OliWozniak/Projekt_EAP_OW/uMule_board/QR.png

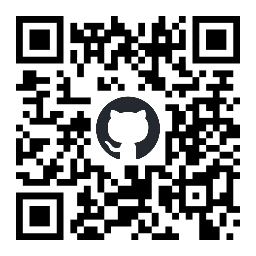
uMule_board/QR.png
