OliWozniak/Projekt_EAP_OW/(list of files, cad)

Other CAD files:
uMule_board/3d_models/uMule_board.step
