OliWozniak/Projekt_EAP_OW/uMule_board/pdf/pcb/uMule_board.pdf

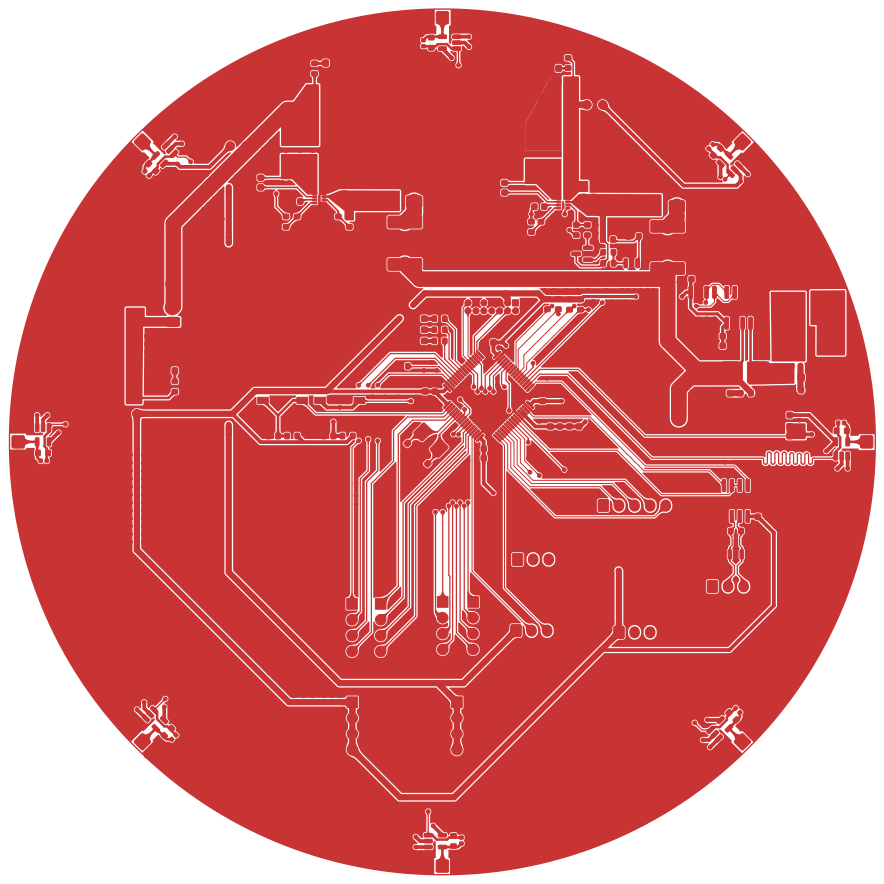
[picture p2: page 1]

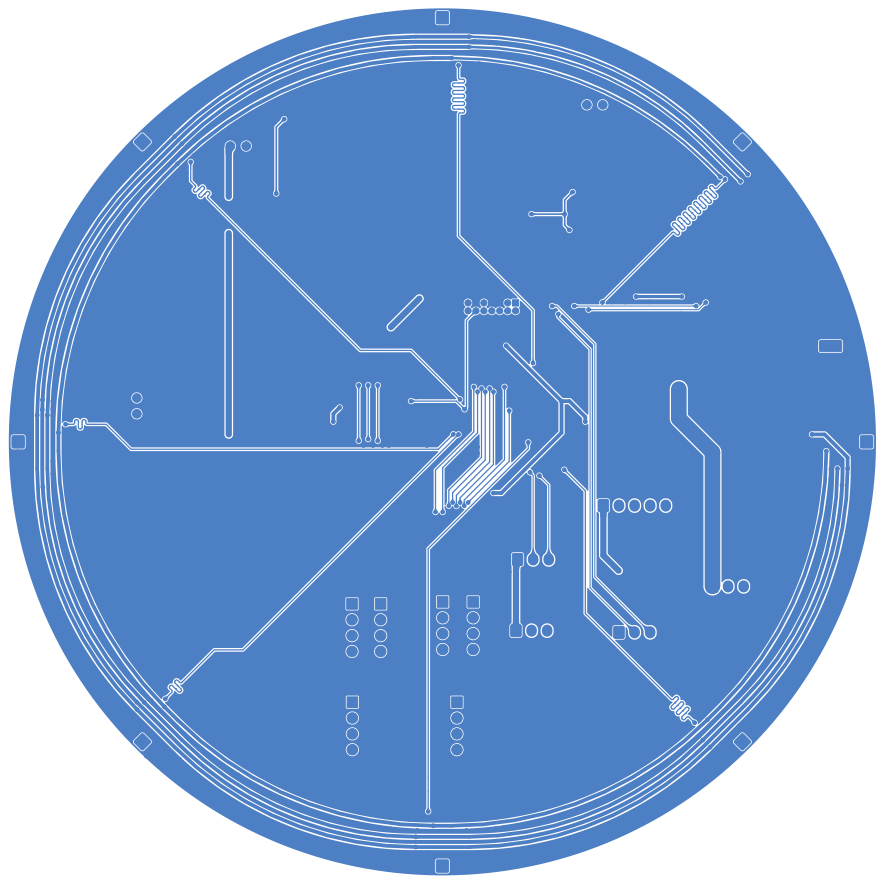
[picture p3: page 2]

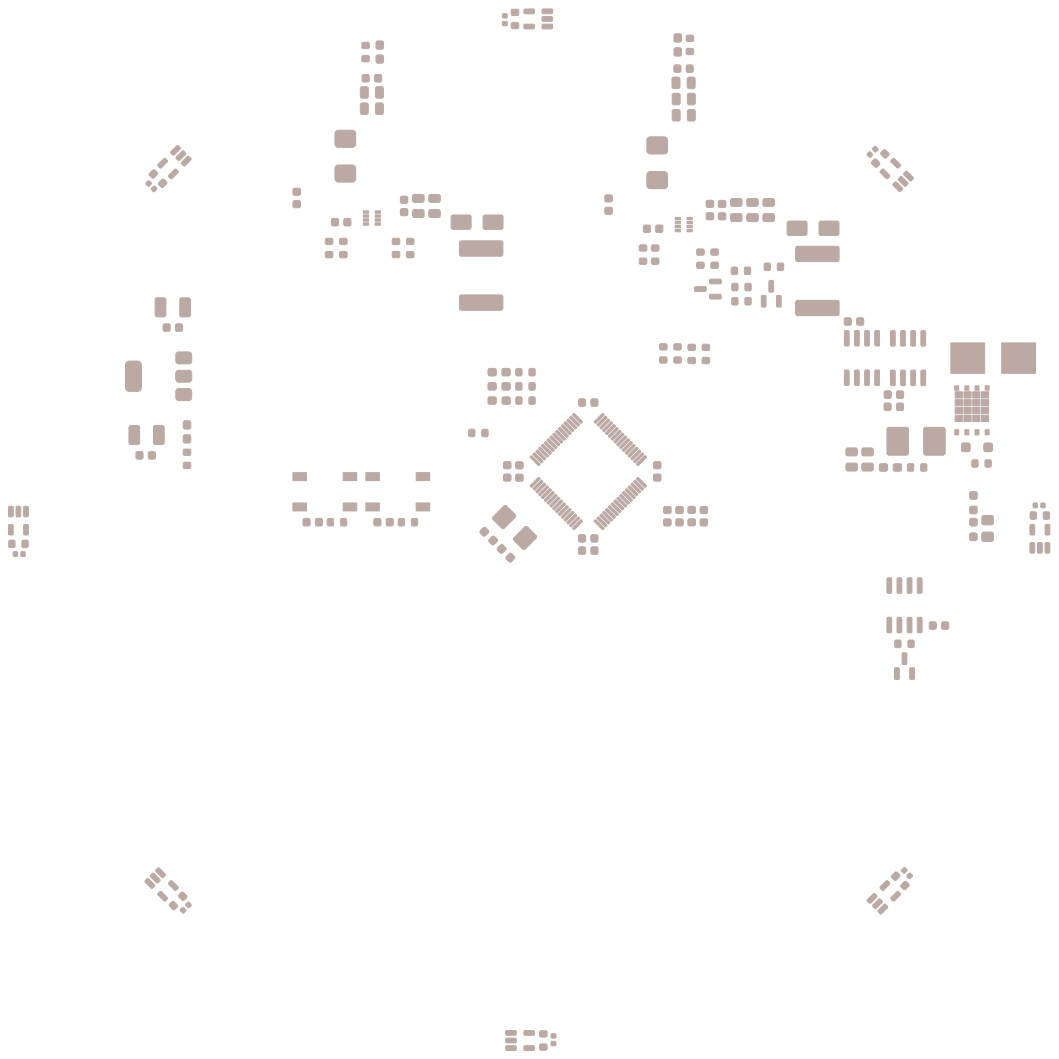
[picture p4: page 3]

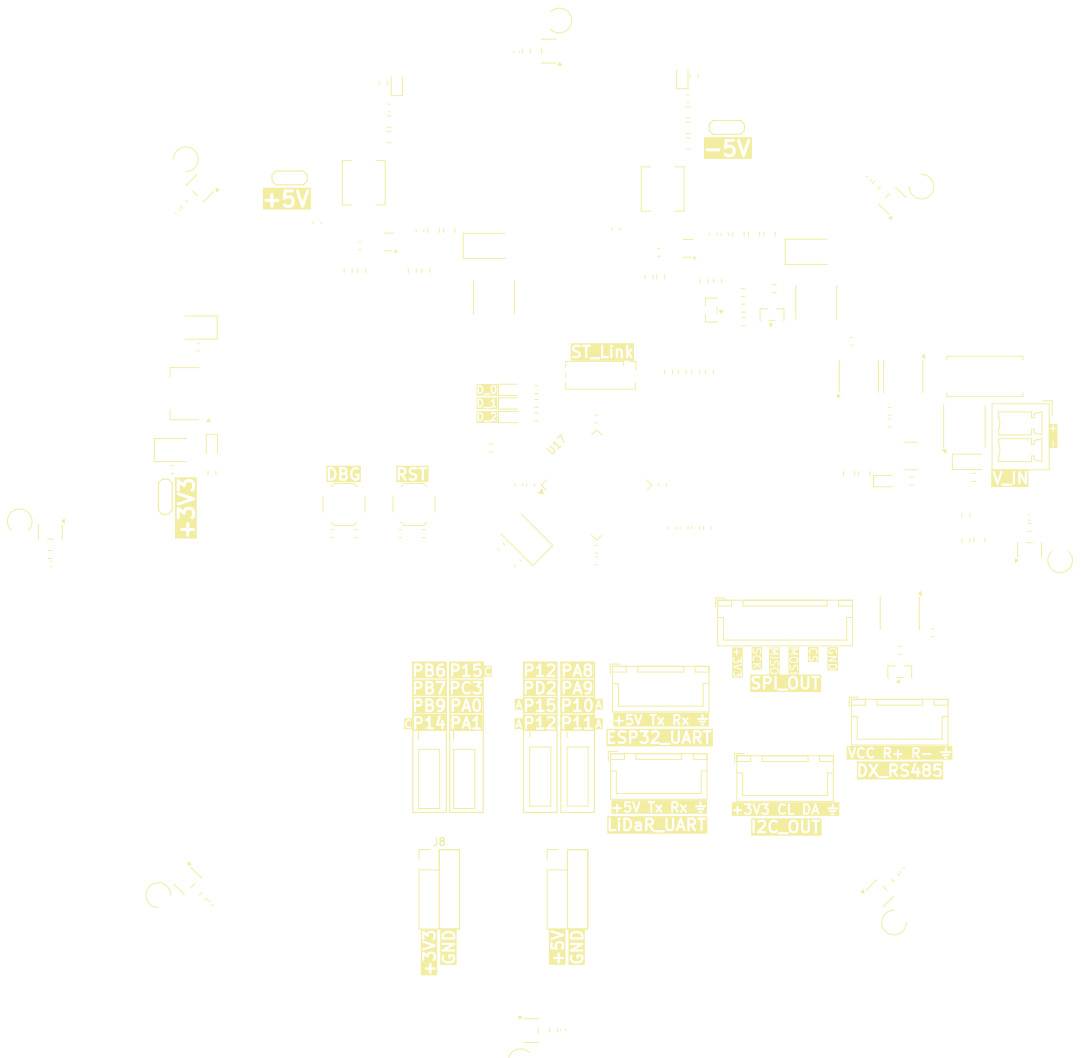
[picture p5: page 5]

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

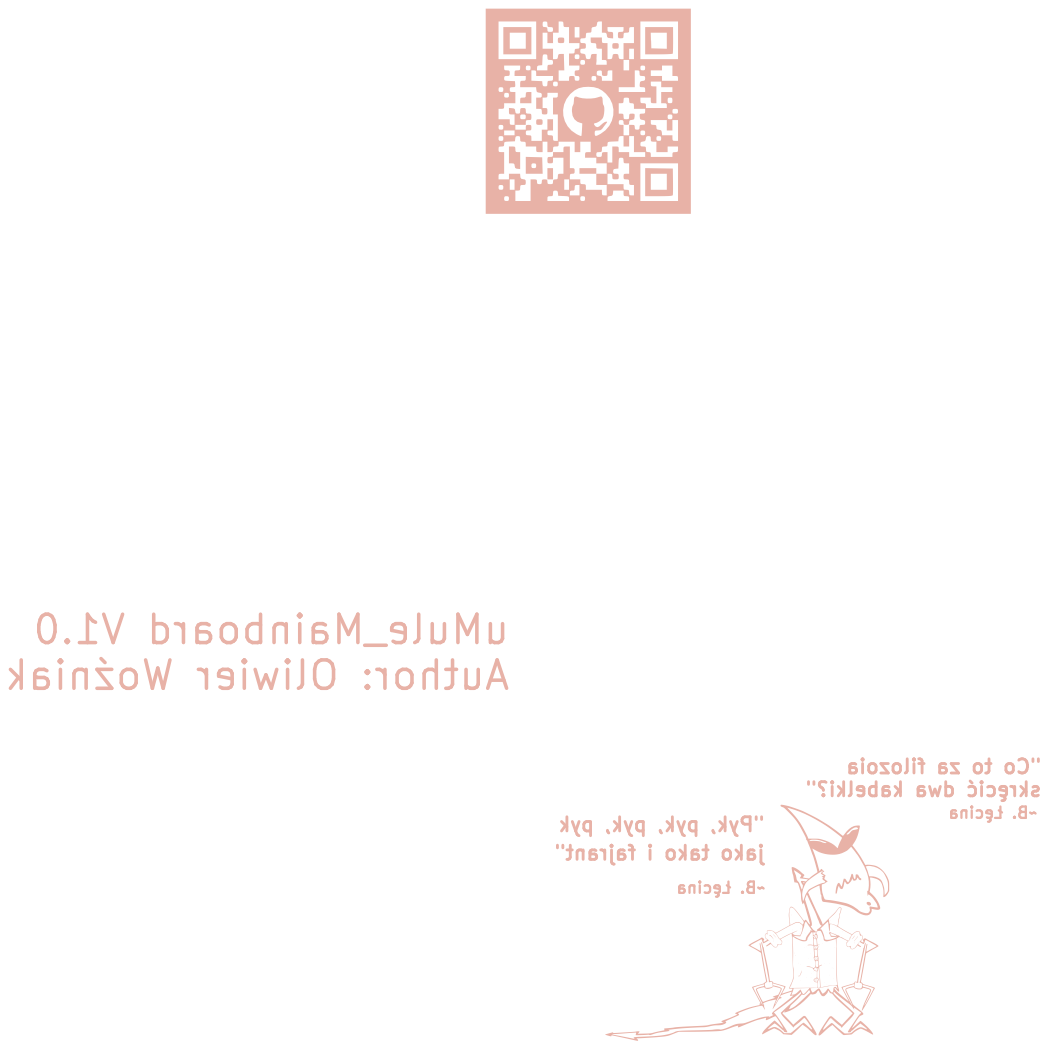
[picture p6: page 6]

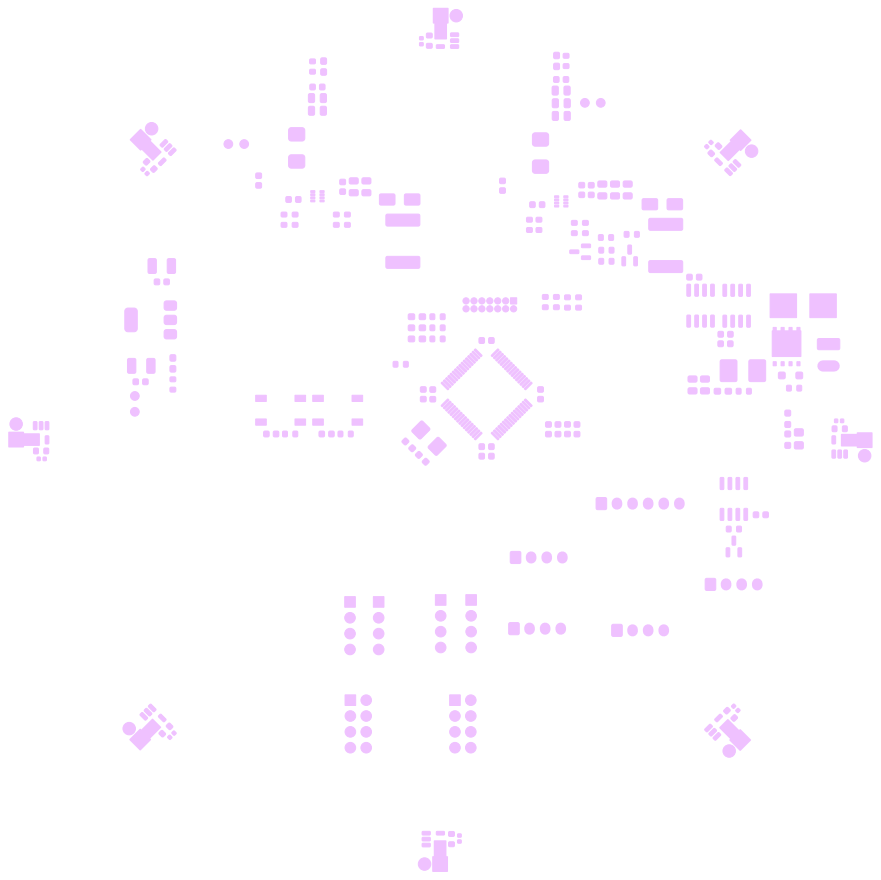
[picture p7: page 7]

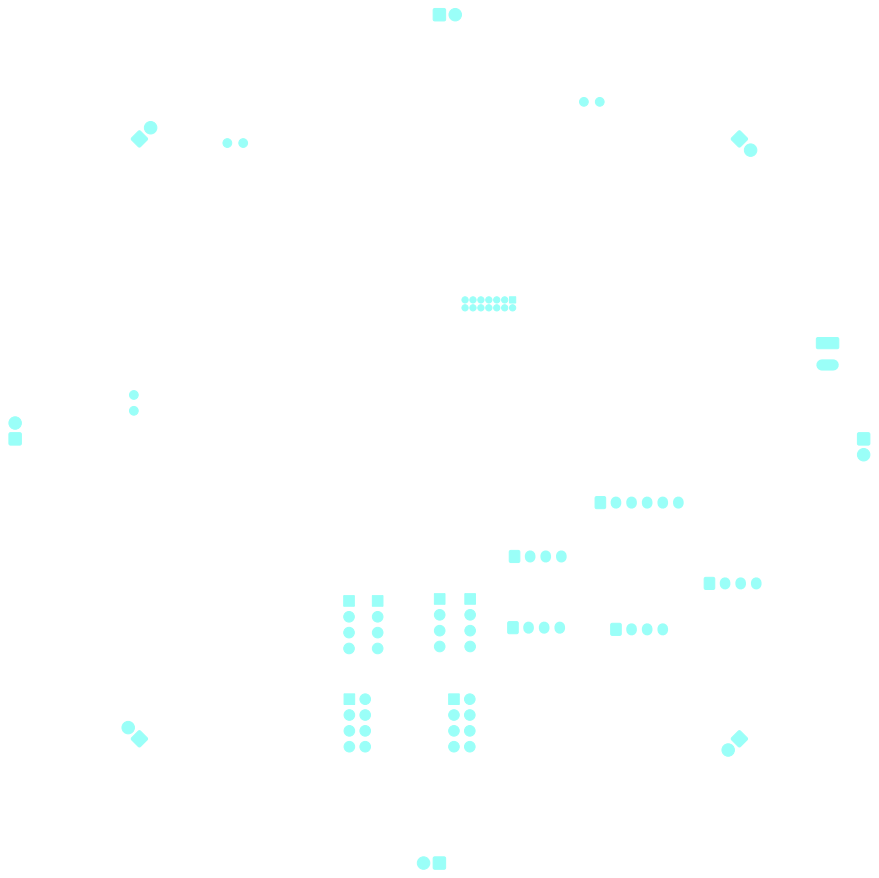
[picture p8: page 8]
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
