OliWozniak/Projekt_EAP_OW/uMule_transmiter/uMule_transmiter.kicad_pcb

## KiCad design uMule_transmiter/uMule_transmiter.kicad_pcb (2026-01-06)

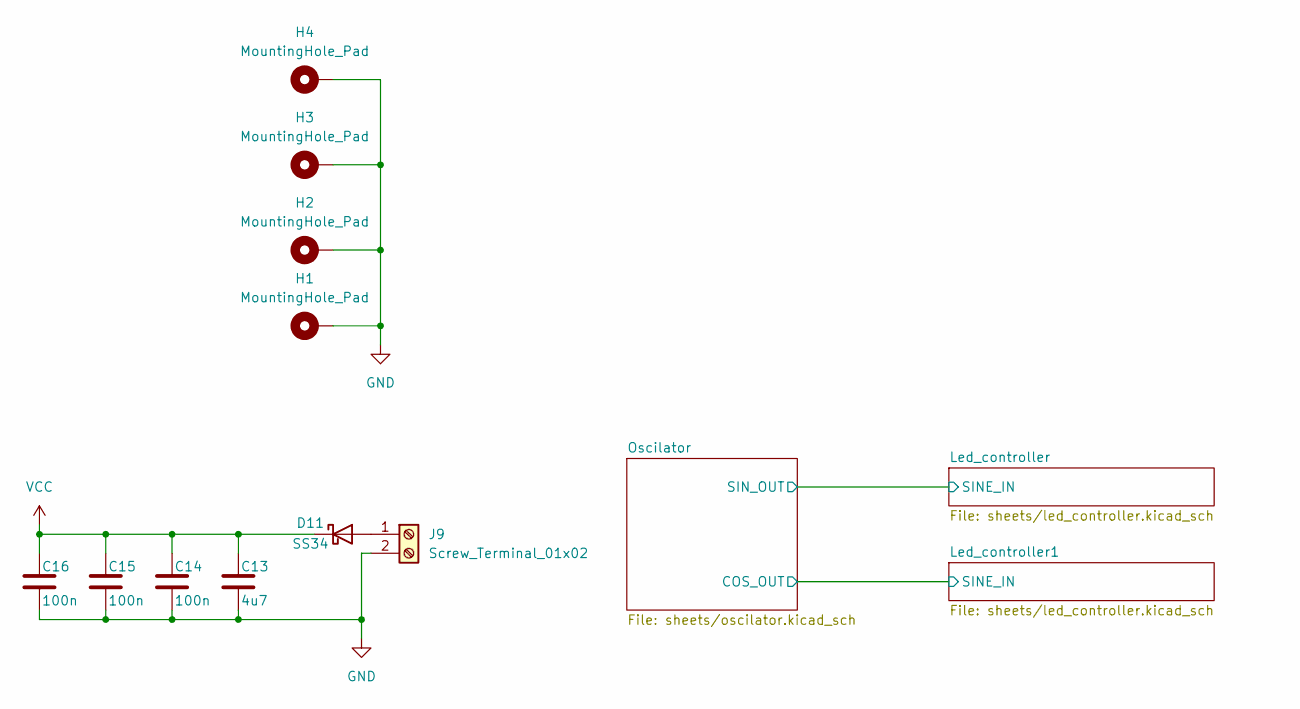
[picture p9: schematic uMule_transmiter.kicad_sch]

Parts:
C13: 4u7; C_0805_2012Metric
C14, C15, C16: 100n; C_0603_1608Metric_Pad1.08x0.95mm_HandSolder
D11: SS34; D_SMA
H1, H2, H3, H4: MountingHole_Pad; MountingHole_3.2mm_M3_Pad_Via
J9: Screw_Terminal_01x02; PhoenixContact_MCV_1,5_2-G-3.5_1x02_P3.50mm_Vertical

Connections:
GND: C13.2, C14.2, C15.2, C16.2, H1.1, H2.1, H3.1, H4.1, J9.2; also elsewhere on the board
unnamed: D11.2 (A), J9.1
VCC: C13.1, C14.1, C15.1, C16.1, D11.1 (K); also elsewhere on the board

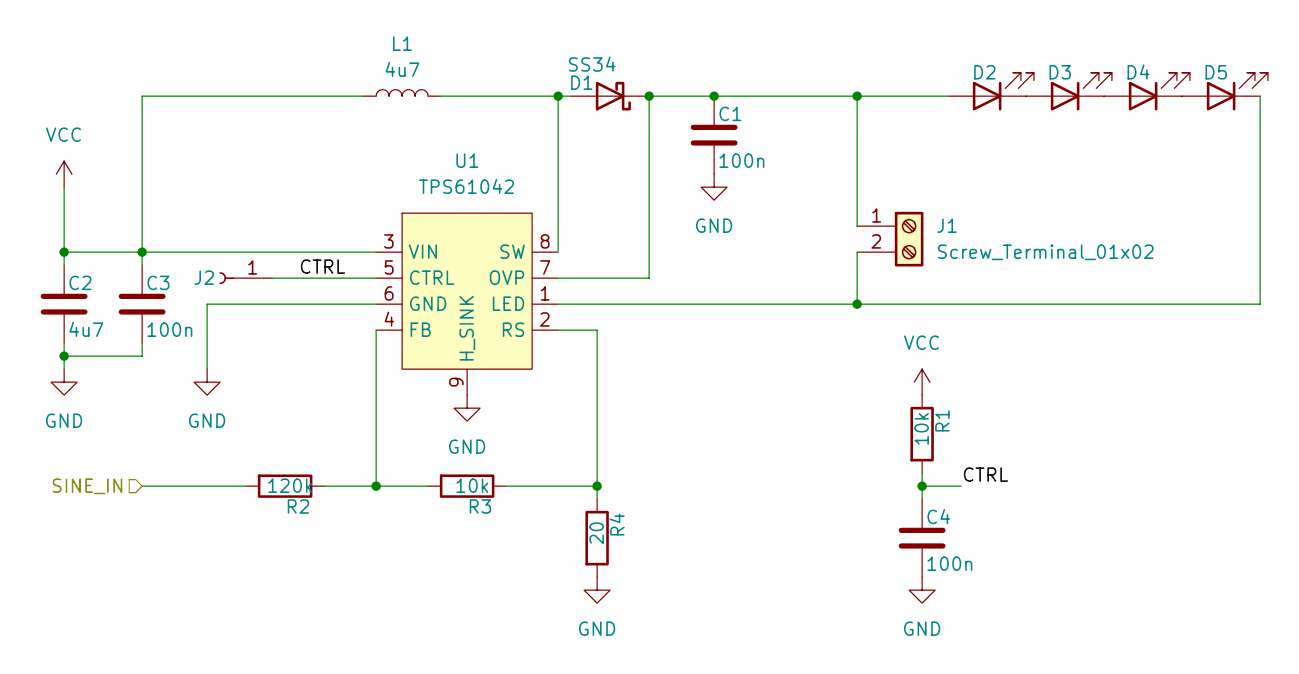
[picture p10: schematic led_controller.kicad_sch]

Parts:
C1, C3, C4: 100n; C_0603_1608Metric_Pad1.08x0.95mm_HandSolder
C2: 4u7; C_0805_2012Metric
D1: SS34; D_SMA
D2, D3, D4, D5: LED; LED_D5.0mm
J1: Screw_Terminal_01x02; PhoenixContact_MCV_1,5_2-G-3.5_1x02_P3.50mm_Vertical
J2: Conn_01x01_Socket; PinHeader_1x01_P2.54mm_Vertical
L1: 4u7; L_APV_ANR3015
R1, R3: 10k; R_0603_1608Metric_Pad0.98x0.95mm_HandSolder
R2: 120k; R_0603_1608Metric_Pad0.98x0.95mm_HandSolder
R4: 20; R_1206_3216Metric_Pad1.30x1.75mm_HandSolder
U1: TPS61042; Texas_S-PVSON-N8

Connections:
/Led_controller/CTRL: C4.1, J2.1, R1.2, U1.5 (CTRL)
/Led_controller/SINE_IN: R2.2; also elsewhere on the board
GND: C1.2, C2.2, C3.2, C4.2, R4.2, U1.6 (GND), U1.9 (H_SINK); also elsewhere on the board
unnamed: D1.2 (A), L1.2, U1.8 (SW)
unnamed: C1.1, D1.1 (K), D2.2 (A), J1.1, U1.7 (OVP)
unnamed: D2.1 (K), D3.2 (A)
unnamed: D3.1 (K), D4.2 (A)
unnamed: D4.1 (K), D5.2 (A)
unnamed: D5.1 (K), J1.2, U1.1 (LED)
unnamed: R2.1, R3.2, U1.4 (FB)
unnamed: R3.1, R4.1, U1.2 (RS)
VCC: C2.1, C3.1, L1.1, R1.1, U1.3 (VIN); also elsewhere on the board

Parts of its further copies:
C5, C7, C8: 100n; C_0603_1608Metric_Pad1.08x0.95mm_HandSolder
C6: 4u7; C_0805_2012Metric
D6: SS34; D_SMA
D7, D8, D9, D10: LED; LED_D5.0mm
J3: Screw_Terminal_01x02; PhoenixContact_MCV_1,5_2-G-3.5_1x02_P3.50mm_Vertical
J4: Conn_01x01_Socket; PinHeader_1x01_P2.54mm_Vertical
L2: 4u7; L_APV_ANR3015
R5, R7: 10k; R_0603_1608Metric_Pad0.98x0.95mm_HandSolder
R6: 120k; R_0603_1608Metric_Pad0.98x0.95mm_HandSolder
R8: 20; R_1206_3216Metric_Pad1.30x1.75mm_HandSolder
U2: TPS61042; Texas_S-PVSON-N8

Connections of its further copies:
/Led_controller1/CTRL: C8.1, J4.1, R5.2, U2.5 (CTRL)
/Led_controller1/SINE_IN: R6.2; also elsewhere on the board
GND: C5.2, C6.2, C7.2, C8.2, R8.2, U2.6 (GND), U2.9 (H_SINK); also elsewhere on the board
unnamed: D6.2 (A), L2.2, U2.8 (SW)
unnamed: C5.1, D6.1 (K), D7.2 (A), J3.1, U2.7 (OVP)
unnamed: D7.1 (K), D8.2 (A)
unnamed: D8.1 (K), D9.2 (A)
unnamed: D9.1 (K), D10.2 (A)
unnamed: D10.1 (K), J3.2, U2.1 (LED)
unnamed: R6.1, R7.2, U2.4 (FB)
unnamed: R7.1, R8.1, U2.2 (RS)
VCC: C6.1, C7.1, L2.1, R5.1, U2.3 (VIN); also elsewhere on the board

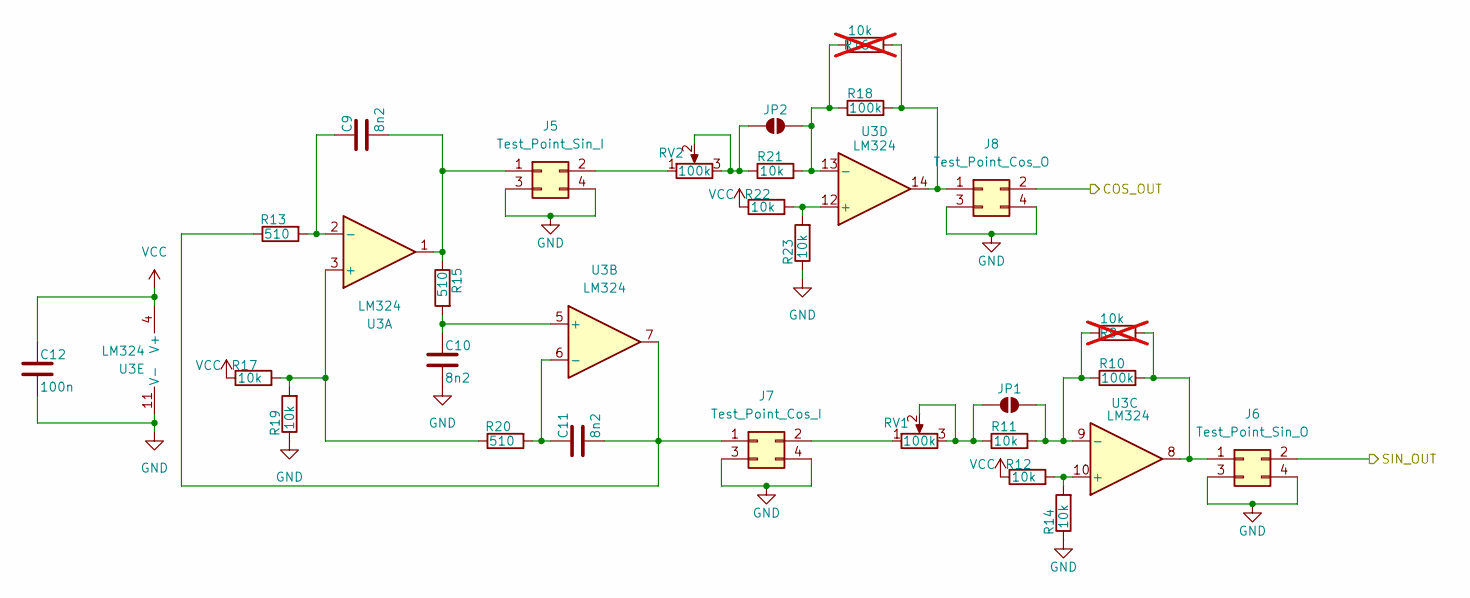
[picture p11: schematic oscilator.kicad_sch]

Parts:
C9, C10, C11: 8n2; C_0603_1608Metric_Pad1.08x0.95mm_HandSolder
C12: 100n; C_0603_1608Metric_Pad1.08x0.95mm_HandSolder
J5: Test_Point_Sin_I; PinHeader_2x02_P2.54mm_Vertical
J6: Test_Point_Sin_O; PinHeader_2x02_P2.54mm_Vertical
J7: Test_Point_Cos_I; PinHeader_2x02_P2.54mm_Vertical
J8: Test_Point_Cos_O; PinHeader_2x02_P2.54mm_Vertical
JP1, JP2: SolderJumper_2_Open; SolderJumper-2_P1.3mm_Open_RoundedPad1.0x1.5mm
R9, R16: 10k; R_Axial_DIN0207_L6.3mm_D2.5mm_P7.62mm_Horizontal; not fitted
R10, R18: 100k; R_0603_1608Metric_Pad0.98x0.95mm_HandSolder
R11, R12, R14, R17, R19, R21, R22, R23: 10k; R_0603_1608Metric_Pad0.98x0.95mm_HandSolder
R13, R15, R20: 510; R_0603_1608Metric_Pad0.98x0.95mm_HandSolder
RV1, RV2: 100k; Potentiometer_Bourns_3266Y_Vertical
U3: LM324; SOIC-14_3.9x8.7mm_P1.27mm

Connections:
/Led_controller1/SINE_IN: J8.2; also elsewhere on the board
/Led_controller/SINE_IN: J6.2; also elsewhere on the board
GND: C10.2, C12.2, J5.3, J5.4, J6.3, J6.4, J7.3, J7.4, J8.3, J8.4, R14.1, R19.1, R23.1, U3.11 (V-); also elsewhere on the board
unnamed: C9.2, J5.1, R15.1, U3.1
unnamed: J5.2, RV2.1
unnamed: J6.1, R9.2, R10.2, U3.8
unnamed: C11.2, J7.1, R13.1, U3.7
unnamed: J7.2, RV1.1
unnamed: J8.1, R16.2, R18.2, U3.14
unnamed: JP1.1 (A), R11.1, RV1.2, RV1.3
unnamed: JP1.2 (B), R9.1, R10.1, R11.2, U3.9 (-)
unnamed: JP2.1 (A), R21.1, RV2.2, RV2.3
unnamed: JP2.2 (B), R16.1, R18.1, R21.2, U3.13 (-)
unnamed: R17.2, R19.2, R20.1, U3.3 (+)
unnamed: C9.1, R13.2, U3.2 (-)
unnamed: C10.1, R15.2, U3.5 (+)
unnamed: C11.1, R20.2, U3.6 (-)
unnamed: R12.2, R14.2, U3.10 (+)
unnamed: R22.2, R23.2, U3.12 (+)
VCC: C12.1, R12.1, R17.1, R22.1, U3.4 (V+); also elsewhere on the board

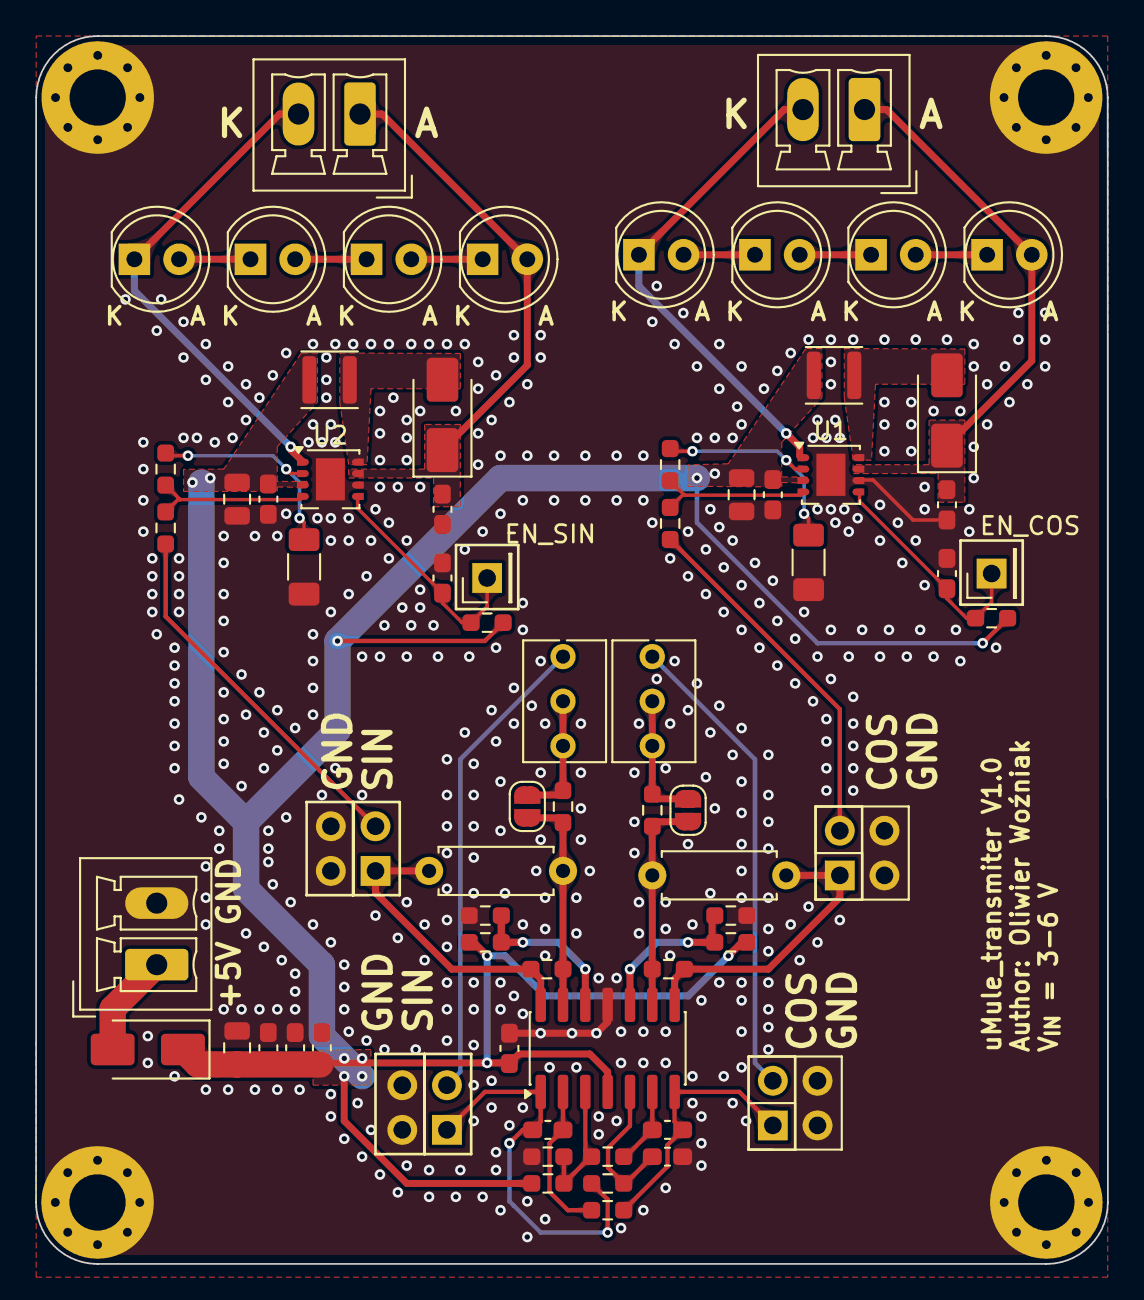
[picture p12: board uMule_transmiter.kicad_pcb from above]

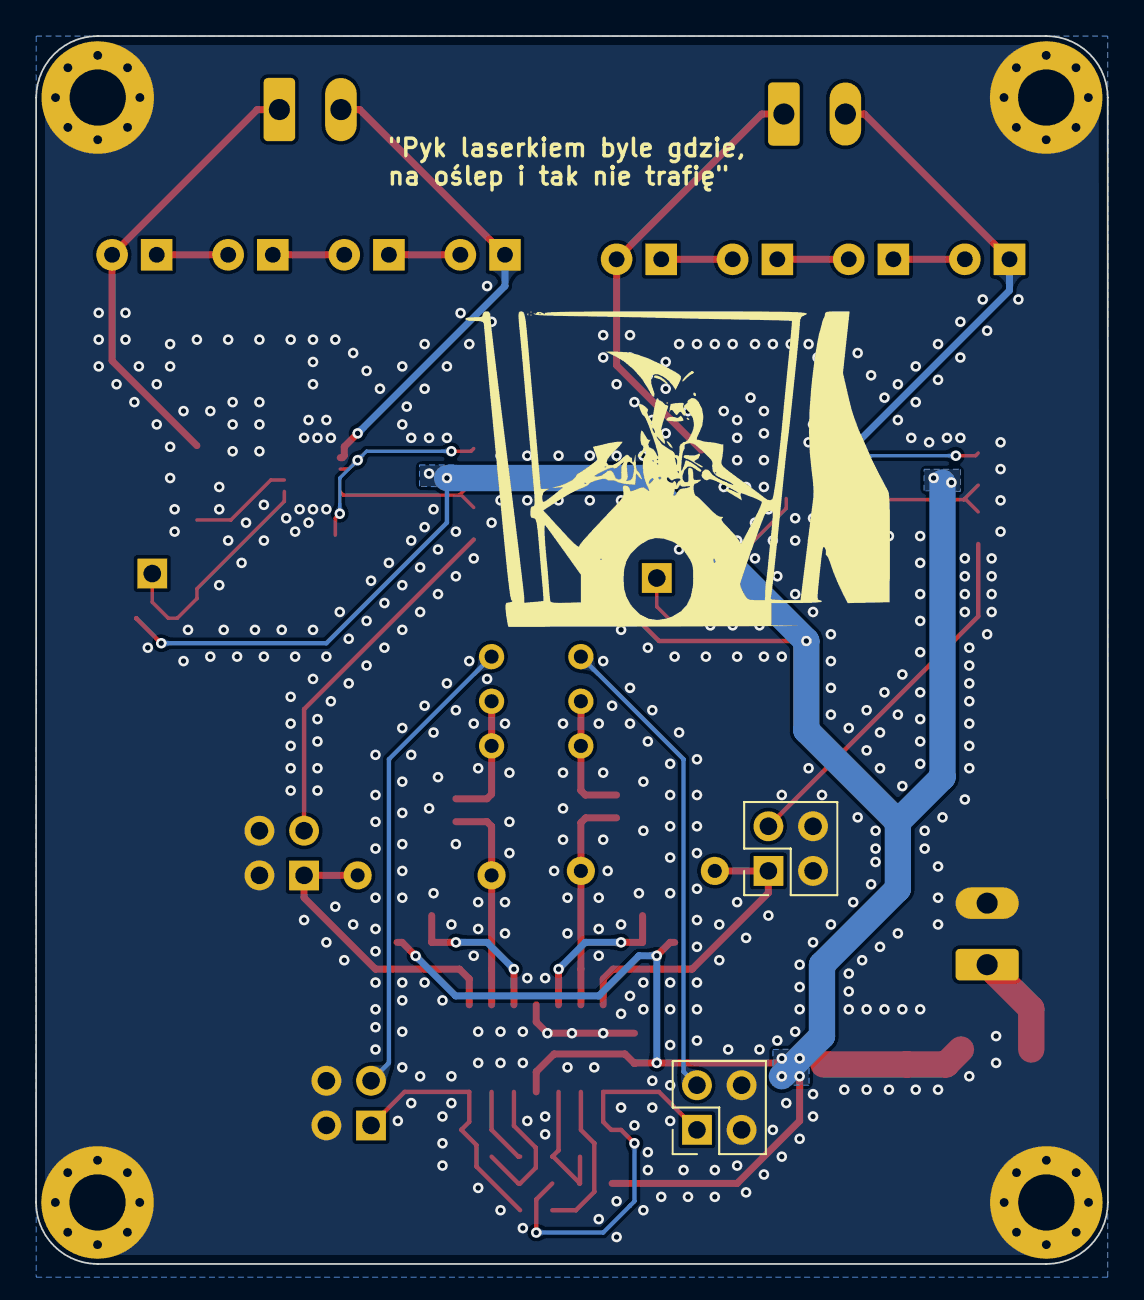
[picture p13: board uMule_transmiter.kicad_pcb from below]

Board: 2 copper layers, 61.0 x 69.9 mm, 72 parts (2 on the bottom side), 39 nets.
