OliWozniak/Projekt_EAP_OW/uMule_board/uMule_board.kicad_pcb

## KiCad design uMule_board/uMule_board.kicad_pcb (2026-01-04)

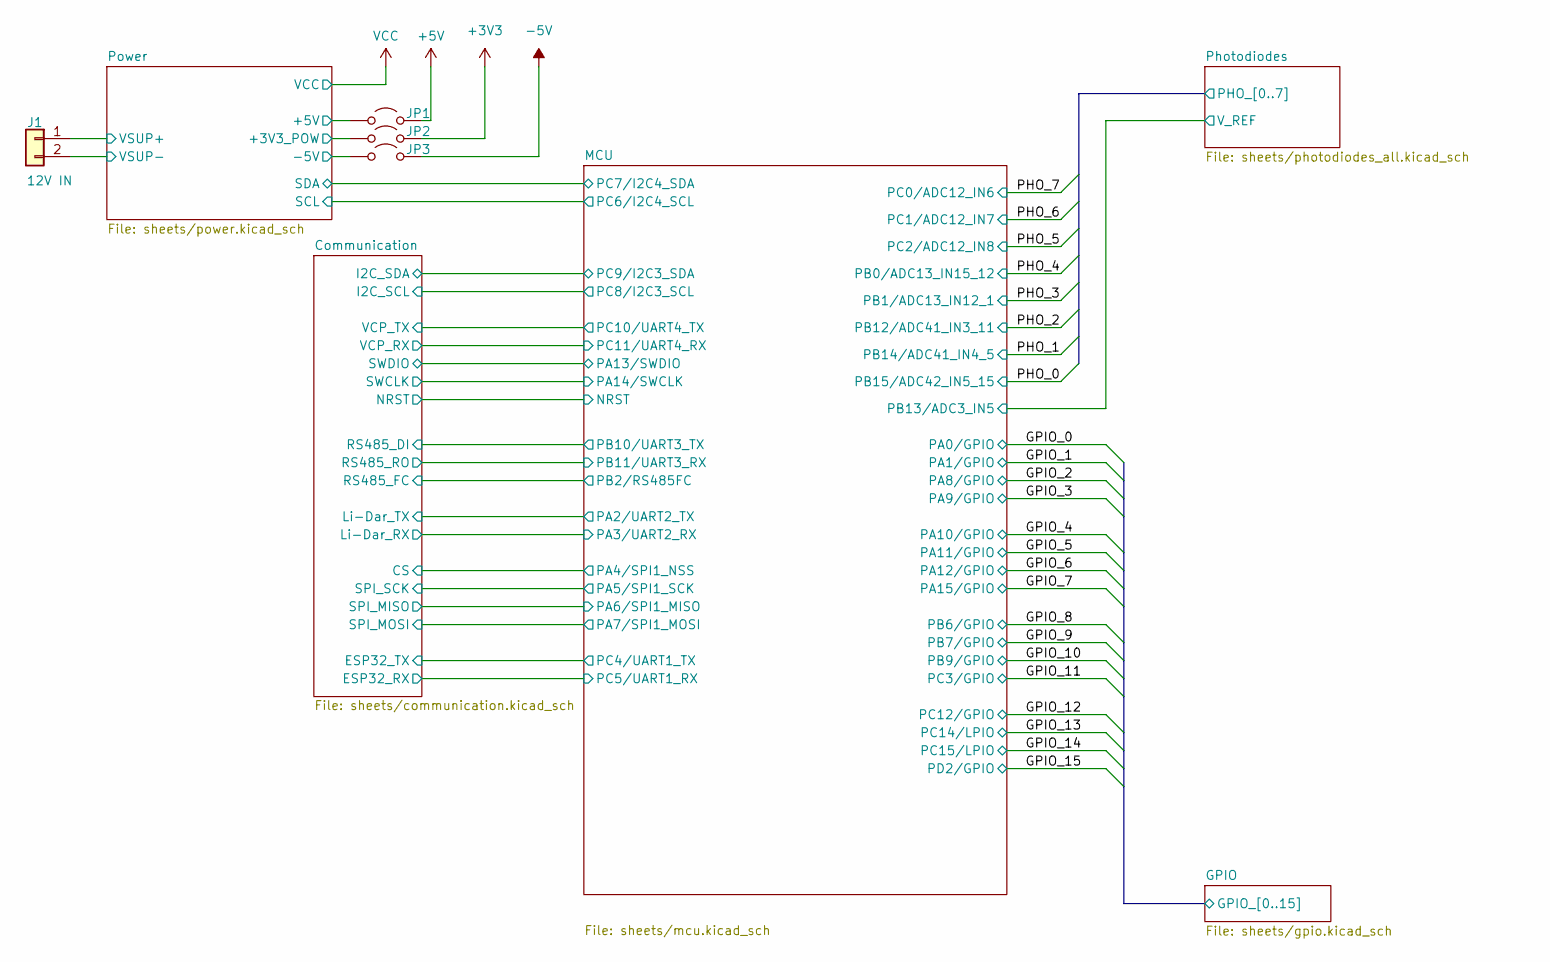
[picture p14: schematic uMule_board.kicad_sch]

Parts:
J1: 12V IN; PhoenixContact_MCV_1,5_2-G-3.5_1x02_P3.50mm_Vertical
JP1, JP2, JP3: Jumper_2_Open; TestPoint_2Pads_Pitch2.54mm_Drill0.8mm

Connections:
+3V3: JP2.2 (B); also elsewhere on the board
+5V: JP1.2 (B); also elsewhere on the board
-5V: JP3.2 (B); also elsewhere on the board
/Power/+3V3_POW: JP2.1 (A); also elsewhere on the board
/Power/+5V: JP1.1 (A); also elsewhere on the board
/Power/-5V: JP3.1 (A); also elsewhere on the board
/Power/VSUP+: J1.1; also elsewhere on the board
GND: J1.2; also elsewhere on the board

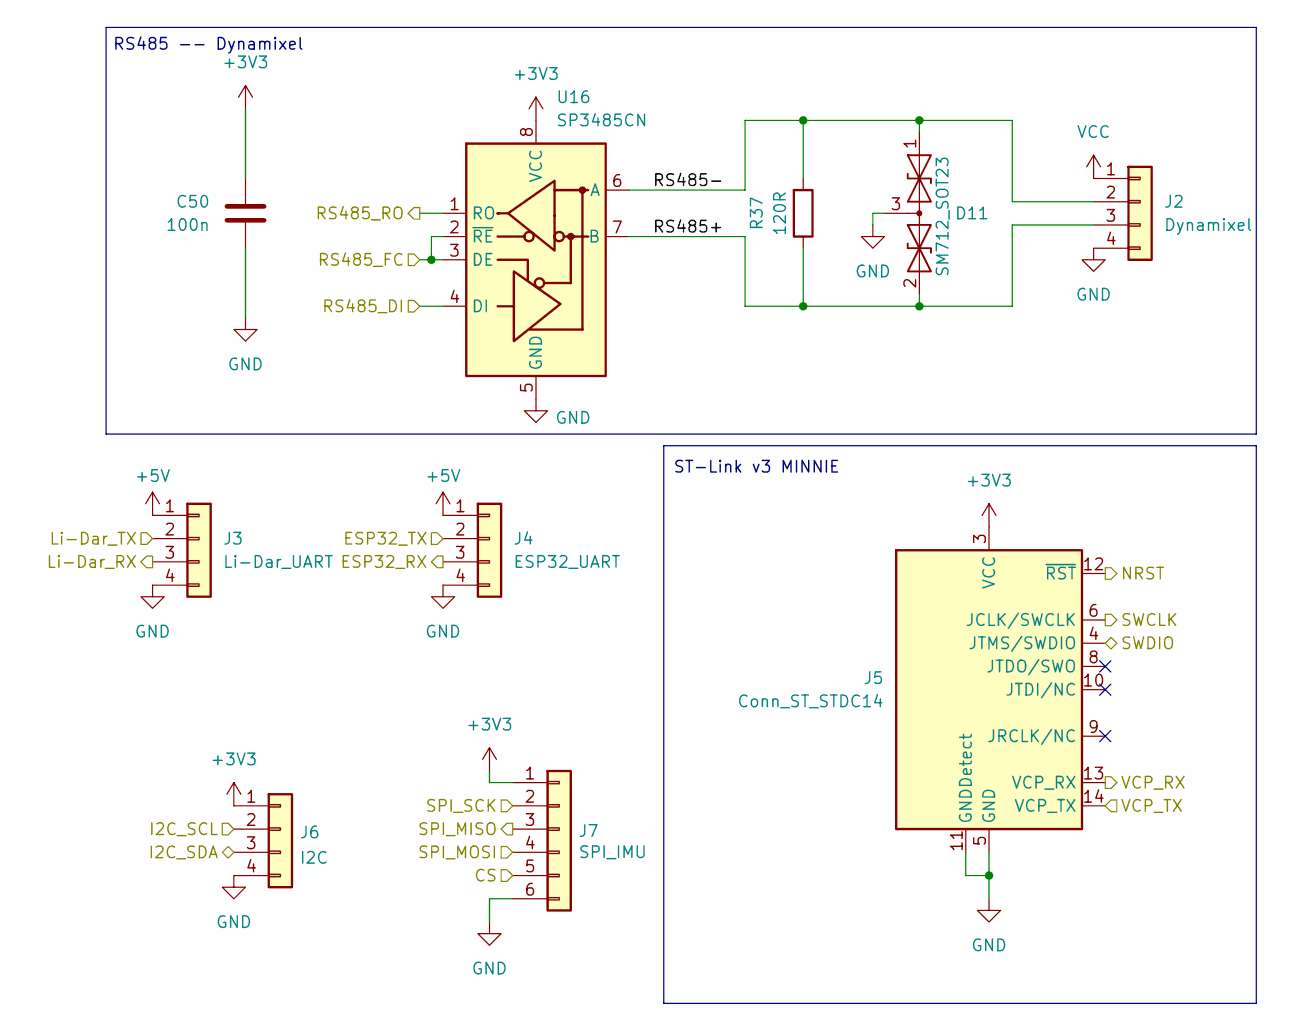
[picture p15: schematic communication.kicad_sch, uMule_board]

Parts:
C50: 100n; C_0603_1608Metric
D11: SM712_SOT23; SOT-23
J2: Dynamixel; JST_XH_B4B-XH-A_1x04_P2.50mm_Vertical
J3: Li-Dar_UART; JST_XH_B4B-XH-A_1x04_P2.50mm_Vertical
J4: ESP32_UART; JST_XH_B4B-XH-A_1x04_P2.50mm_Vertical
J5: Conn_ST_STDC14; PinHeader_2x07_P1.27mm_Vertical
J6: I2C; JST_XH_B4B-XH-A_1x04_P2.50mm_Vertical
J7: SPI_IMU; JST_XH_B6B-XH-A_1x06_P2.50mm_Vertical
R37: 120R; R_0603_1608Metric
U16: SP3485CN; SOIC-8_3.9x4.9mm_P1.27mm

Connections:
+3V3: C50.2, J5.3 (VCC), J6.1, J7.1, U16.8 (VCC); also elsewhere on the board
+5V: J3.1, J4.1; also elsewhere on the board
/Communication/CS: J7.5; also elsewhere on the board
/Communication/ESP32_RX: J4.3; also elsewhere on the board
/Communication/ESP32_TX: J4.2; also elsewhere on the board
/Communication/I2C_SCL: J6.2; also elsewhere on the board
/Communication/I2C_SDA: J6.3; also elsewhere on the board
/Communication/Li-Dar_RX: J3.3; also elsewhere on the board
/Communication/Li-Dar_TX: J3.2; also elsewhere on the board
/Communication/RS485+: D11.2 (A2), J2.3, R37.1, U16.7 (B)
/Communication/RS485-: D11.1 (A1), J2.2, R37.2, U16.6 (A)
/Communication/RS485_DI: U16.4 (DI); also elsewhere on the board
/Communication/RS485_FC: U16.2 (~RE), U16.3 (DE); also elsewhere on the board
/Communication/RS485_RO: U16.1 (RO); also elsewhere on the board
/Communication/SPI_MISO: J7.3; also elsewhere on the board
/Communication/SPI_MOSI: J7.4; also elsewhere on the board
/Communication/SPI_SCK: J7.2; also elsewhere on the board
/Communication/SWCLK: J5.6 (JCLK/SWCLK); also elsewhere on the board
/Communication/SWDIO: J5.4 (JTMS/SWDIO); also elsewhere on the board
/Communication/VCP_RX: J5.13 (VCP_RX); also elsewhere on the board
/Communication/VCP_TX: J5.14 (VCP_TX); also elsewhere on the board
/MCU/NRST: J5.12 (~RST); also elsewhere on the board
GND: C50.1, D11.3 (common), J2.4, J3.4, J4.4, J5.5 (GND), J5.7 (GND), J5.11 (GNDDetect), J6.4, J7.6, U16.5 (GND); also elsewhere on the board
VCC: J2.1; also elsewhere on the board

Notes on the sheet:
RS485 -- Dynamixel
ST-Link v3 MINNIE

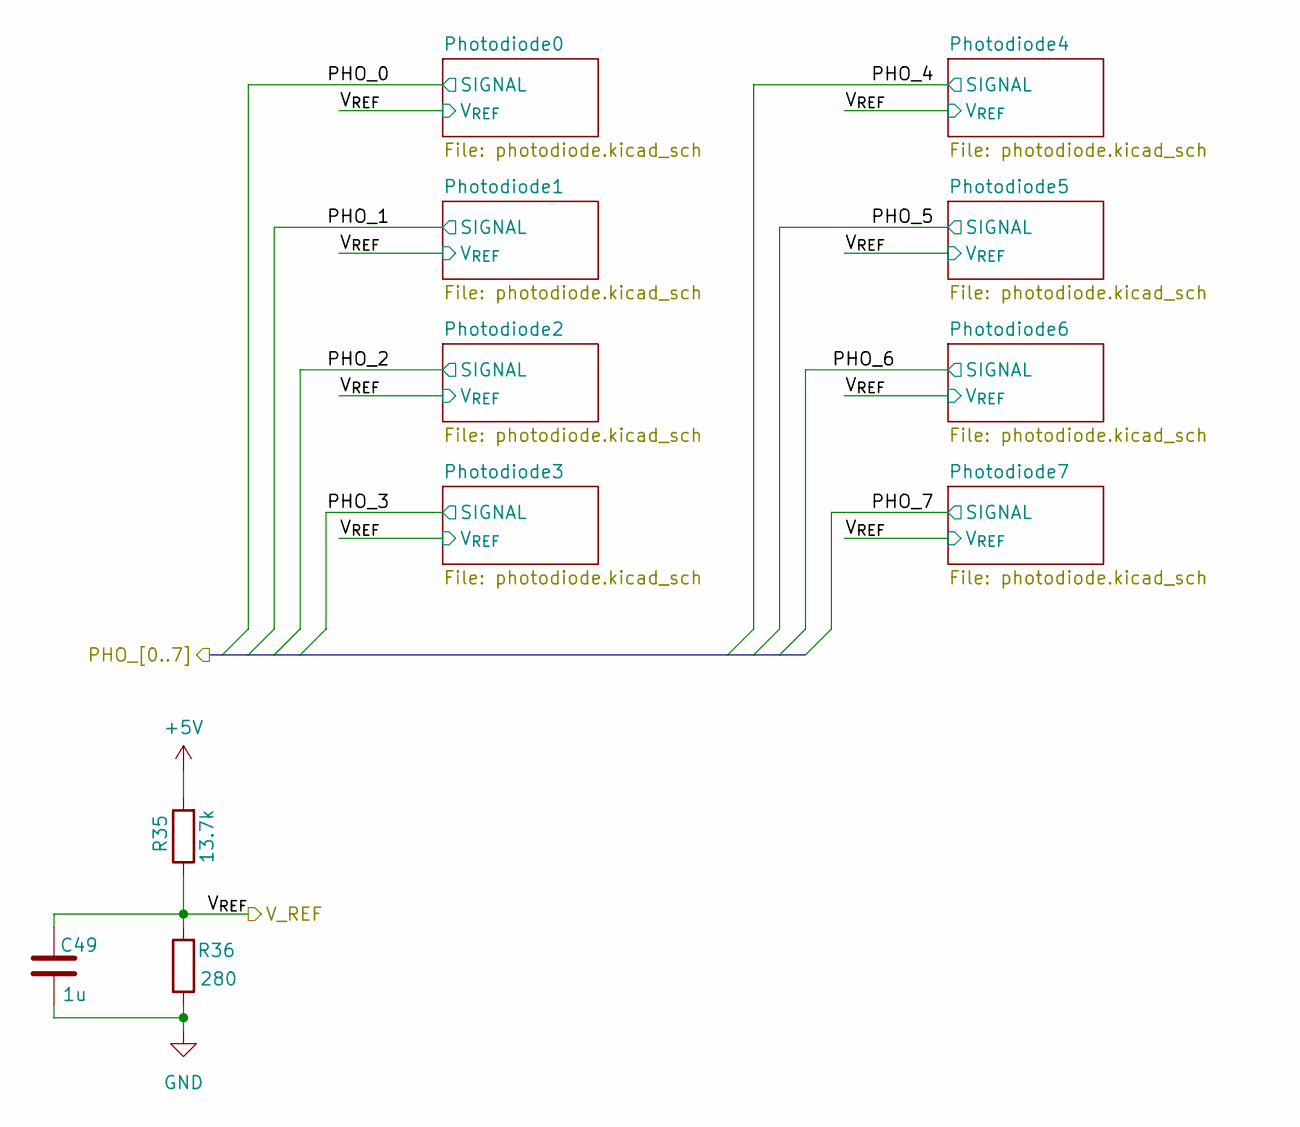
[picture p16: schematic photodiodes_all.kicad_sch, uMule_board]

Parts:
C49: 1u; C_0805_2012Metric_Pad1.18x1.45mm_HandSolder
R35: 13.7k; R_0603_1608Metric_Pad0.98x0.95mm_HandSolder
R36: 280; R_0603_1608Metric_Pad0.98x0.95mm_HandSolder

Connections:
+5V: R35.2; also elsewhere on the board
/Photodiodes/V_{REF}: C49.1, R35.1, R36.2; also elsewhere on the board
GND: C49.2, R36.1; also elsewhere on the board

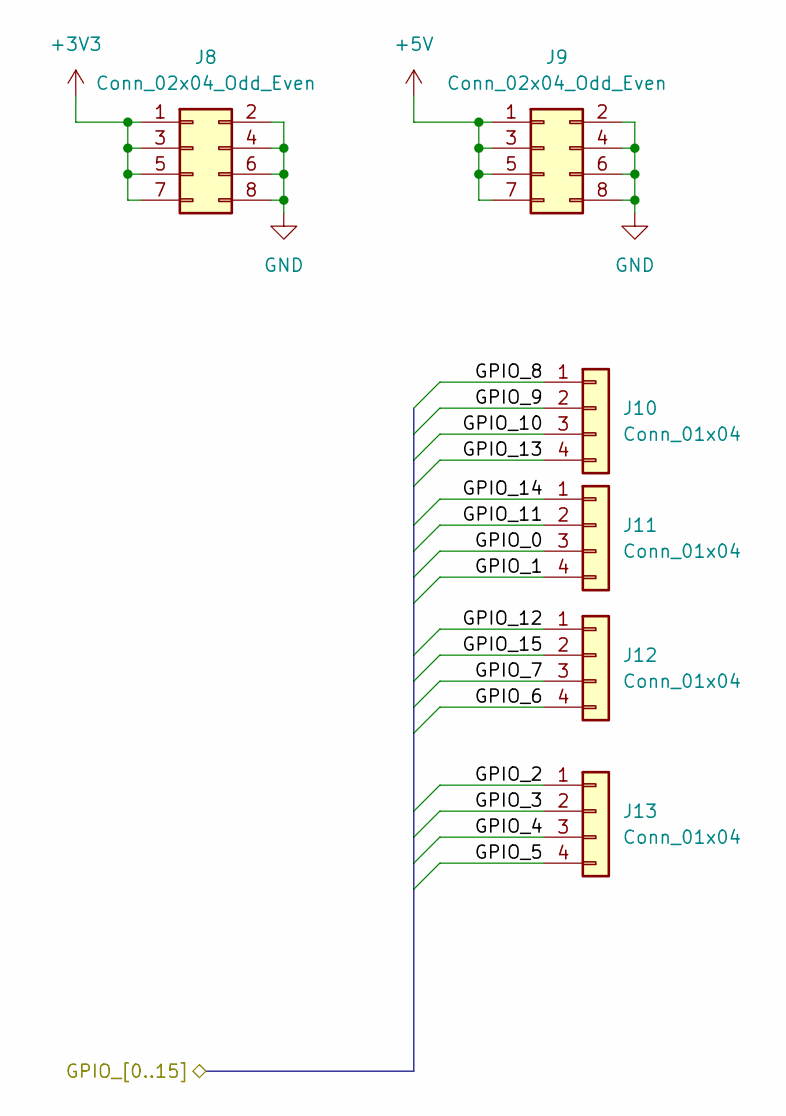
[picture p17: schematic gpio.kicad_sch, uMule_board]

Parts:
J8, J9: Conn_02x04_Odd_Even; PinHeader_2x04_P2.54mm_Vertical
J10, J11, J12, J13: Conn_01x04; PinHeader_1x04_P2.54mm_Vertical

Connections:
+3V3: J8.1, J8.3, J8.5, J8.7; also elsewhere on the board
+5V: J9.1, J9.3, J9.5, J9.7; also elsewhere on the board
/GPIO/GPIO_0: J11.3; also elsewhere on the board
/GPIO/GPIO_1: J11.4; also elsewhere on the board
/GPIO/GPIO_2: J13.1; also elsewhere on the board
/GPIO/GPIO_3: J13.2; also elsewhere on the board
/GPIO/GPIO_4: J13.3; also elsewhere on the board
/GPIO/GPIO_5: J13.4; also elsewhere on the board
/GPIO/GPIO_6: J12.4; also elsewhere on the board
/GPIO/GPIO_7: J12.3; also elsewhere on the board
/GPIO/GPIO_8: J10.1; also elsewhere on the board
/GPIO/GPIO_9: J10.2; also elsewhere on the board
/GPIO/GPIO_10: J10.3; also elsewhere on the board
/GPIO/GPIO_11: J11.2; also elsewhere on the board
/GPIO/GPIO_12: J12.1; also elsewhere on the board
/GPIO/GPIO_13: J10.4; also elsewhere on the board
/GPIO/GPIO_14: J11.1; also elsewhere on the board
/GPIO/GPIO_15: J12.2; also elsewhere on the board
GND: J8.2, J8.4, J8.6, J8.8, J9.2, J9.4, J9.6, J9.8; also elsewhere on the board

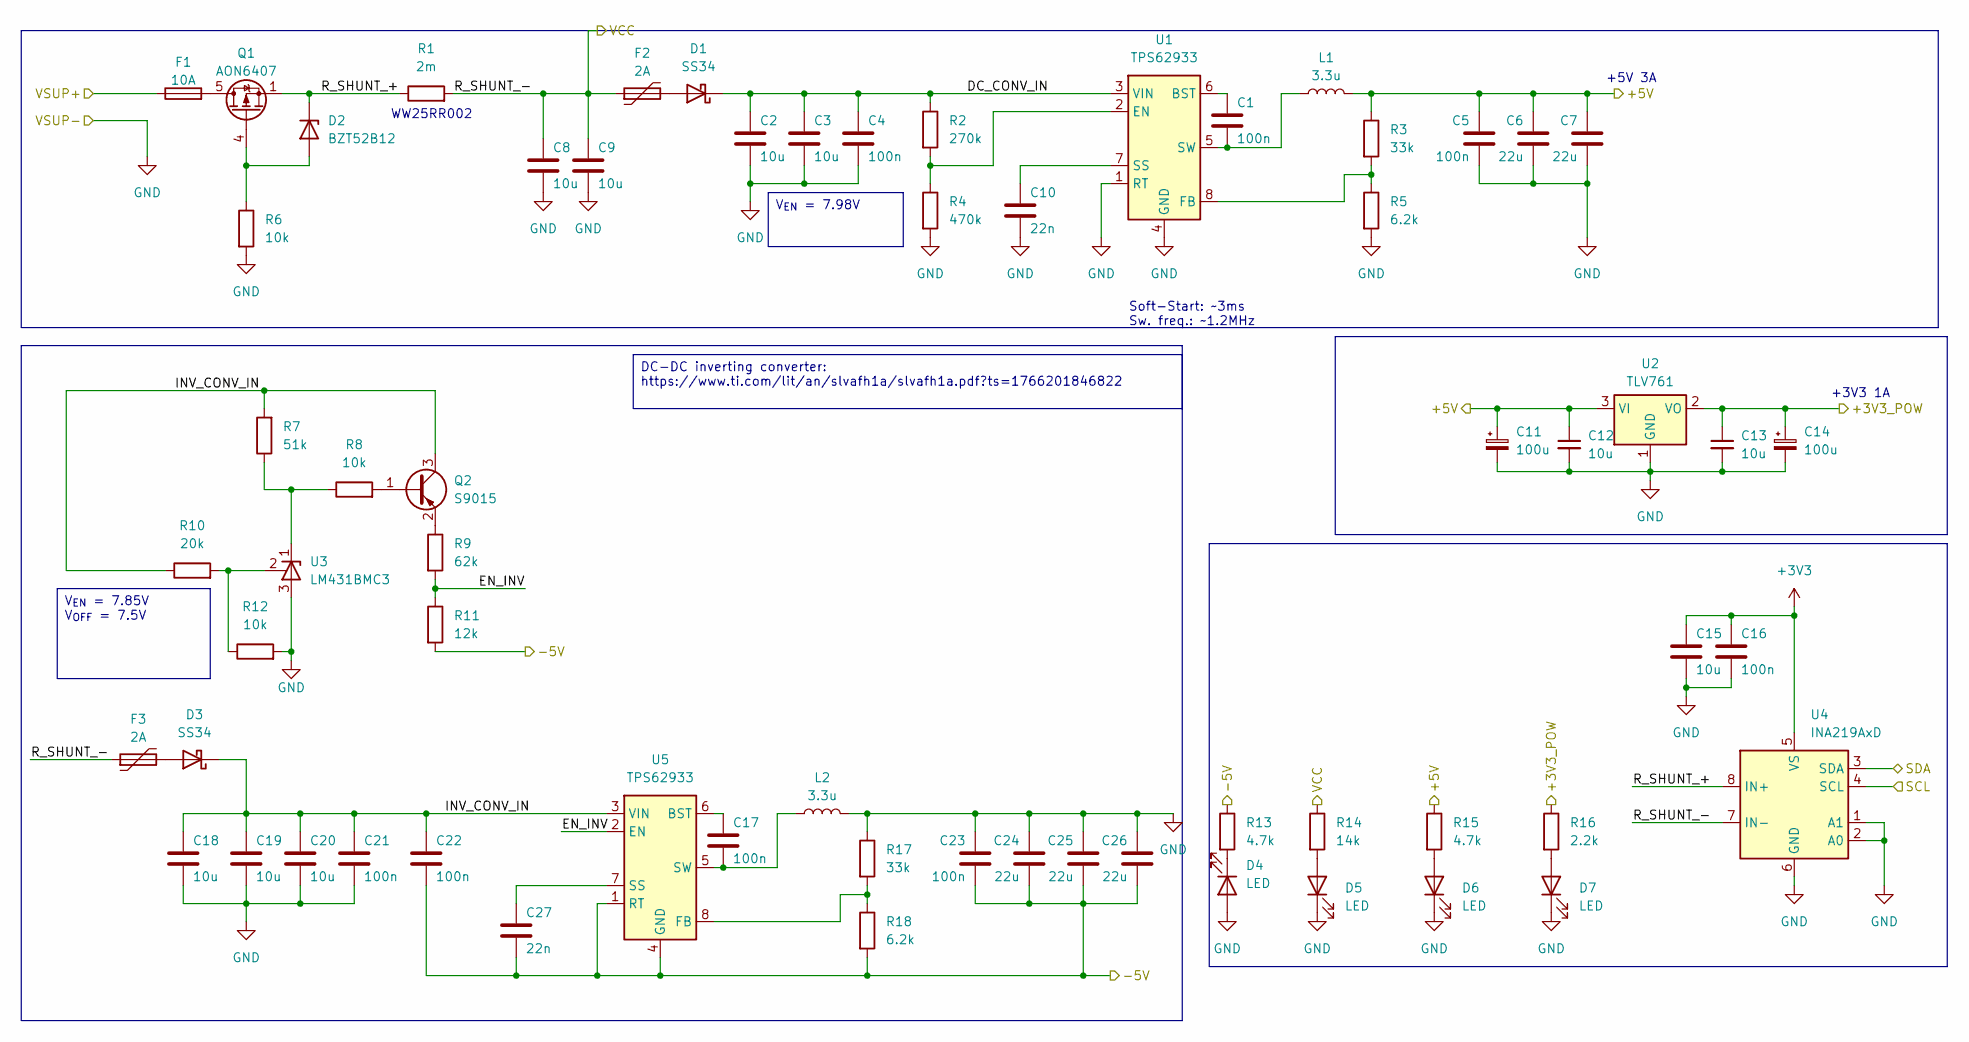
[picture p18: schematic power.kicad_sch, uMule_board]

Parts:
C1, C4, C5, C16, C17, C21, C22, C23: 100n; C_0603_1608Metric
C2, C3, C8, C9, C18, C19, C20: 10u; C_0805_2012Metric
C6, C7, C24, C25, C26: 22u; C_0805_2012Metric
C10, C27: 22n; C_0603_1608Metric
C11, C14: 100u; CP_EIA-3528-21_Kemet-B
C12, C13, C15: 10u; C_0603_1608Metric
D1, D3: SS34; D_SMA
D2: BZT52B12; D_SOD-123F
D4, D5, D6, D7: LED; LED_0603_1608Metric_Pad1.05x0.95mm_HandSolder
F1: 10A; Fuseholder_Littelfuse_Nano2_154x
F2, F3: 2A; Fuse_2920_7451Metric
L1, L2: 3.3u; Inductor_TKD_SPM5030VT; jlc C1512760
Q1: AON6407; AO_DFN-8-1EP_5.55x5.2mm_P1.27mm_EP4.12x4.6mm
Q2: S9015; SOT-23
R1: 2m; R_Shunt_2512
R2: 270k; R_0603_1608Metric
R3, R17: 33k; R_0603_1608Metric
R4: 470k; R_0603_1608Metric
R5, R18: 6.2k; R_0603_1608Metric
R6, R8, R12: 10k; R_0603_1608Metric
R7: 51k; R_0603_1608Metric
R9: 62k; R_0603_1608Metric
R10: 20k; R_0603_1608Metric
R11: 12k; R_0603_1608Metric
R13, R15: 4.7k; R_0603_1608Metric
R14: 14k; R_0603_1608Metric
R16: 2.2k; R_0603_1608Metric
U1, U5: TPS62933; SOT-583-8
U2: TLV761; SOT-223-3_TabPin2
U3: LM431BMC3; SOT-23
U4: INA219AxD; SOIC-8_3.9x4.9mm_P1.27mm

Connections:
+3V3: C15.1, C16.1, U4.5 (VS); also elsewhere on the board
/MCU/PC6/I2C4_SCL: U4.4 (SCL); also elsewhere on the board
/MCU/PC7/I2C4_SDA: U4.3 (SDA); also elsewhere on the board
/Power/+3V3_POW: C13.1, C14.1, R16.1, U2.2 (VO); also elsewhere on the board
/Power/+5V: C5.1, C6.1, C7.1, C11.1, C12.1, L1.2, R3.1, R15.1, U2.3 (VI); also elsewhere on the board
/Power/-5V: C22.2, C23.2, C24.2, C25.2, C26.2, C27.2, R11.2, R13.1, R18.2, U5.1 (RT), U5.4 (GND); also elsewhere on the board
/Power/DC_CONV_IN: C2.1, C3.1, C4.1, D1.1 (K), R2.1, U1.3 (VIN)
/Power/EN_INV: R9.2, R11.1, U5.2 (EN)
/Power/INV_CONV_IN: C18.1, C19.1, C20.1, C21.1, C22.1, D3.1 (K), Q2.3 (C), R7.2, R10.1, U5.3 (VIN)
/Power/R_SHUNT_+: D2.1 (K), Q1.1 (S), Q1.2 (S), Q1.3 (S), R1.1, U4.8 (IN+)
/Power/VSUP+: F1.1; also elsewhere on the board
GND: C2.2, C3.2, C4.2, C5.2, C6.2, C7.2, C8.2, C9.2, C10.2, C11.2, C12.2, C13.2, C14.2, C15.2, C16.2, C18.2, C19.2, C20.2, C21.2, C23.1, C24.1, C25.1, C26.1, D4.2 (A), D5.1 (K), D6.1 (K), D7.1 (K), L2.2, R4.2, R5.2, R6.2, R12.2, R17.1, U1.1 (RT), U1.4 (GND), U2.1 (GND), U3.3 (A), U4.1 (A1), U4.2 (A0), U4.6 (GND); also elsewhere on the board
unnamed: D1.2 (A), F2.2
unnamed: D2.2 (A), Q1.4 (G), R6.1
unnamed: D3.2 (A), F3.2
unnamed: D4.1 (K), R13.2
unnamed: D5.2 (A), R14.2
unnamed: D6.2 (A), R15.2
unnamed: D7.2 (A), R16.2
unnamed: F1.2, Q1.5 (D)
unnamed: Q2.1 (B), R8.2
unnamed: Q2.2 (E), R9.1
unnamed: C1.1, U1.6 (BST)
unnamed: R2.2, R4.1, U1.2 (EN)
unnamed: R3.2, R5.1, U1.8 (FB)
unnamed: C10.1, U1.7 (SS)
unnamed: C1.2, L1.1, U1.5 (SW)
unnamed: R7.1, R8.1, U3.1 (K)
unnamed: R10.2, R12.1, U3.2 (REF)
unnamed: C17.1, U5.6 (BST)
unnamed: R17.2, R18.1, U5.8 (FB)
unnamed: C27.1, U5.7 (SS)
unnamed: C17.2, L2.1, U5.5 (SW)
VCC: C8.1, C9.1, F2.1, F3.1, R1.2, R14.1, U4.7 (IN-); also elsewhere on the board

Notes on the sheet:
+3V3 1A
+5V 3A
Soft-Start: ~3ms Sw. freq.: ~1.2MHz
WW25RR002
V_{EN} = 7.85V V_{OFF} = 7.5V
V_{EN} = 7.98V
DC-DC inverting converter: https://www.ti.com/lit/an/slvafh1a/slvafh1a.pdf?ts=1766201846822
