OliWozniak/Projekt_EAP_OW/uMule_board/uMule_board.kicad_pcb

## KiCad design uMule_board/uMule_board.kicad_pcb (continued)

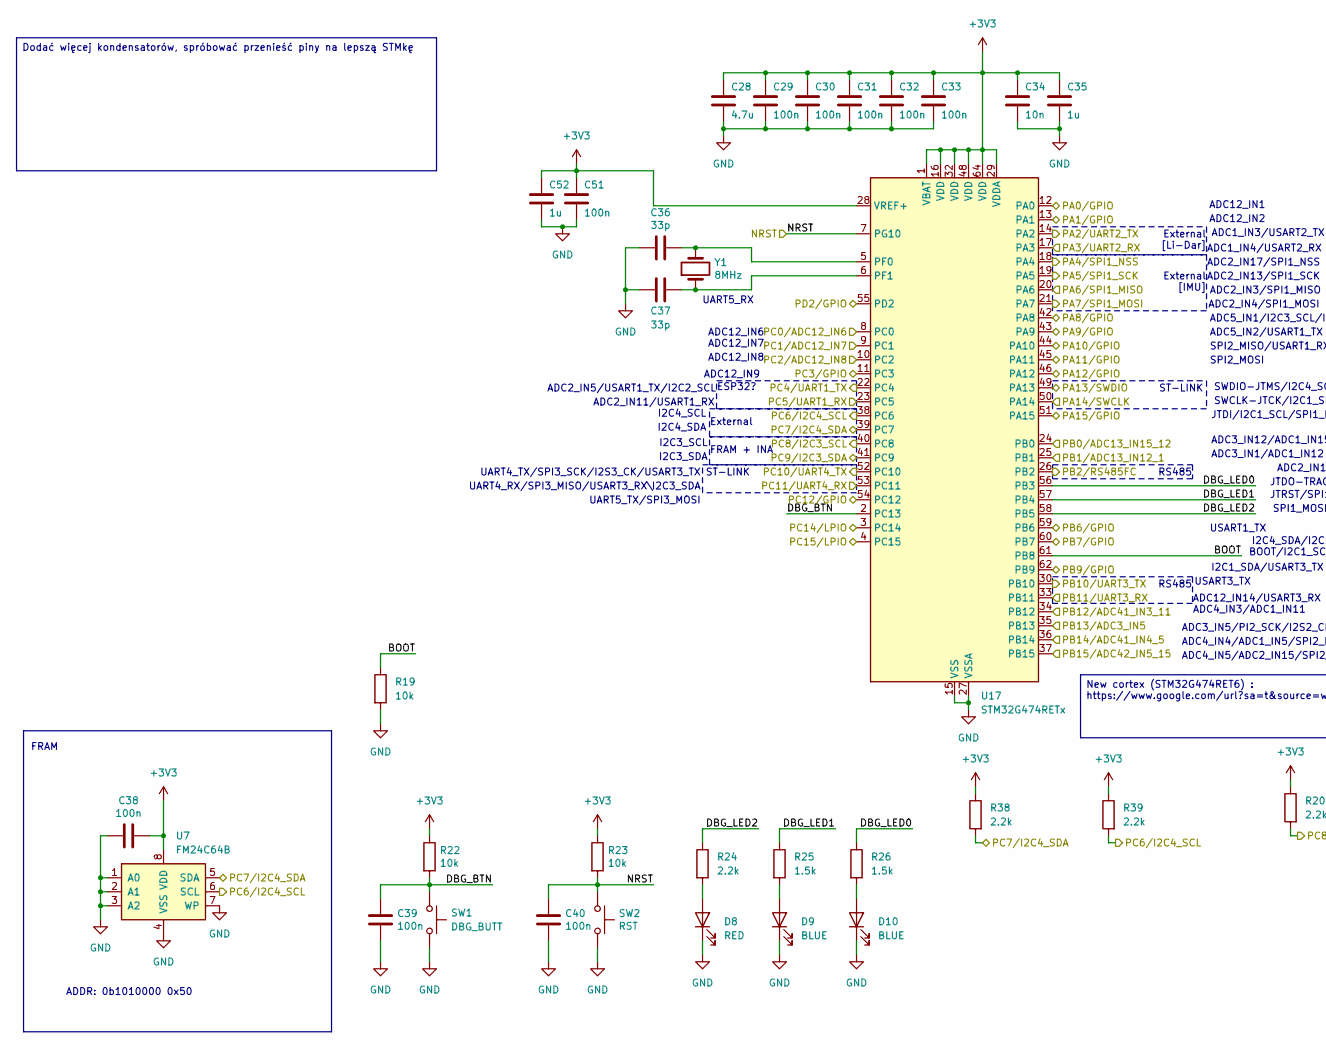
[picture p19: schematic mcu.kicad_sch, uMule_board, part in row 1, column 1]

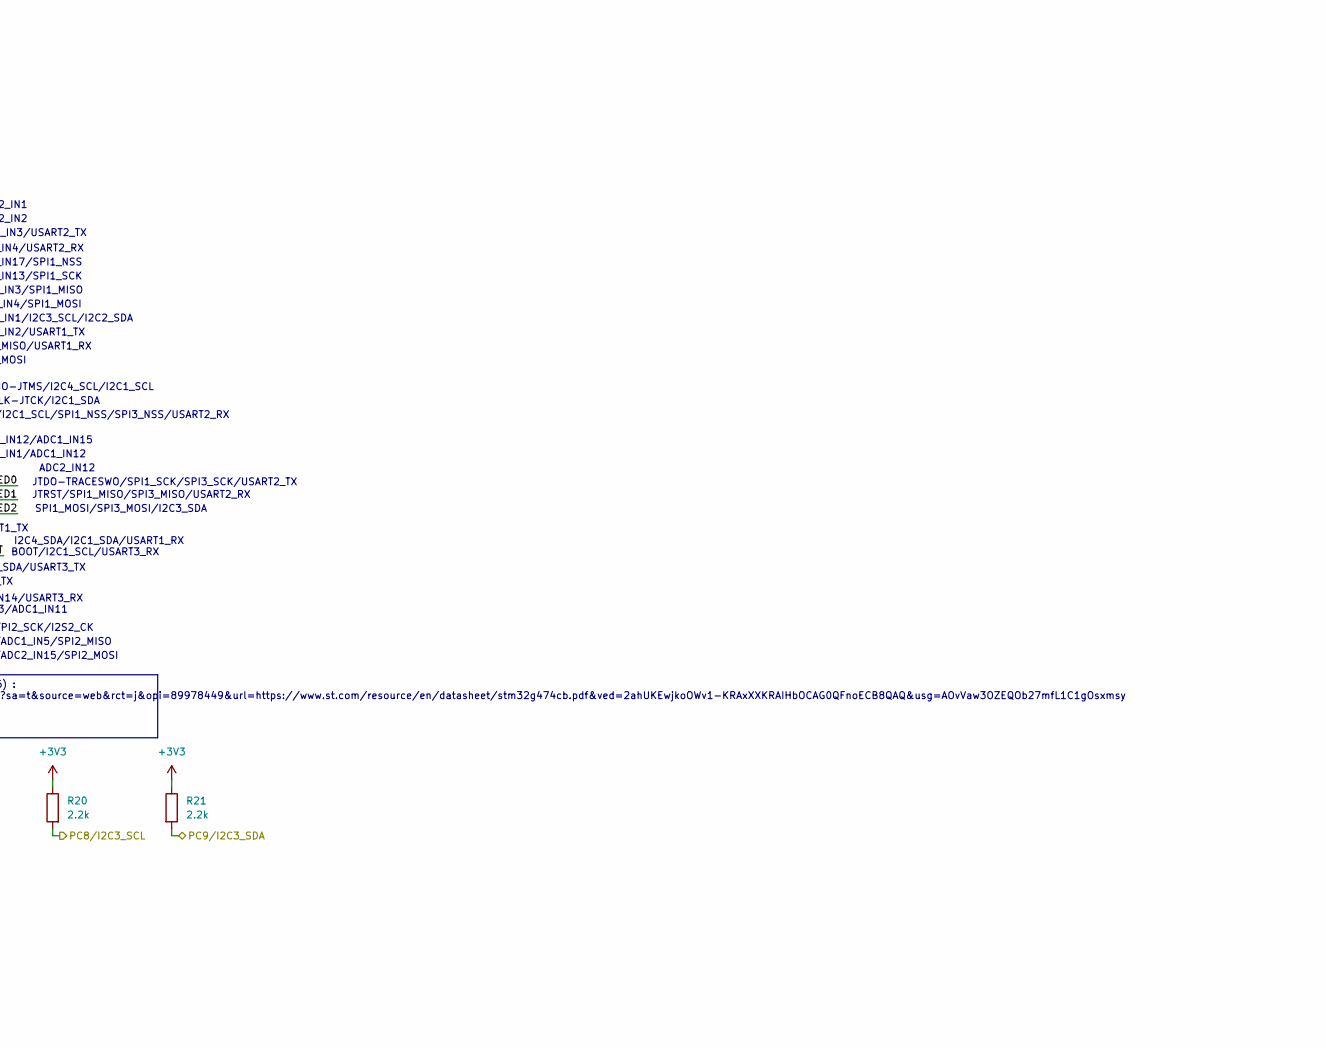
[picture p20: schematic mcu.kicad_sch, uMule_board, part in row 1, column 2]

Parts:
C28: 4.7u; C_0603_1608Metric
C29, C30, C31, C32, C33, C38, C39, C40, C51: 100n; C_0603_1608Metric
C34: 10n; C_0603_1608Metric
C35, C52: 1u; C_0603_1608Metric
C36, C37: 33p; C_0603_1608Metric
D8: RED; LED_0603_1608Metric_Pad1.05x0.95mm_HandSolder
D9, D10: BLUE; LED_0603_1608Metric_Pad1.05x0.95mm_HandSolder
R19, R22, R23: 10k; R_0603_1608Metric
R20, R21, R24, R38, R39: 2.2k; R_0603_1608Metric
R25, R26: 1.5k; R_0603_1608Metric
SW1: DBG_BUTT; SW_SPST_TL3342
SW2: RST; SW_SPST_TL3342
U7: FM24C64B; SOIC-8_3.9x4.9mm_P1.27mm
U17: STM32G474RETx; LQFP-64_10x10mm_P0.5mm
Y1: 8MHz; Crystal_SMD_5032-2Pin_5.0x3.2mm

Connections:
+3V3: C28.1, C29.1, C30.1, C31.1, C32.1, C33.1, C34.1, C35.1, C38.1, C51.1, C52.1, R20.1, R21.1, R22.1, R23.1, R38.1, R39.1, U7.8 (VDD), U17.1 (VBAT), U17.16 (VDD), U17.28 (VREF+), U17.29 (VDDA), U17.32 (VDD), U17.48 (VDD), U17.64 (VDD); also elsewhere on the board
/Communication/CS: U17.18 (PA4); also elsewhere on the board
/Communication/ESP32_RX: U17.23 (PC5); also elsewhere on the board
/Communication/ESP32_TX: U17.22 (PC4); also elsewhere on the board
/Communication/I2C_SCL: R20.2, U17.40 (PC8); also elsewhere on the board
/Communication/I2C_SDA: R21.2, U17.41 (PC9); also elsewhere on the board
/Communication/Li-Dar_RX: U17.17 (PA3); also elsewhere on the board
/Communication/Li-Dar_TX: U17.14 (PA2); also elsewhere on the board
/Communication/RS485_DI: U17.30 (PB10); also elsewhere on the board
/Communication/RS485_FC: U17.26 (PB2); also elsewhere on the board
/Communication/RS485_RO: U17.33 (PB11); also elsewhere on the board
/Communication/SPI_MISO: U17.20 (PA6); also elsewhere on the board
/Communication/SPI_MOSI: U17.21 (PA7); also elsewhere on the board
/Communication/SPI_SCK: U17.19 (PA5); also elsewhere on the board
/Communication/SWCLK: U17.50 (PA14); also elsewhere on the board
/Communication/SWDIO: U17.49 (PA13); also elsewhere on the board
/Communication/VCP_RX: U17.53 (PC11); also elsewhere on the board
/Communication/VCP_TX: U17.52 (PC10); also elsewhere on the board
/GPIO/GPIO_0: U17.12 (PA0); also elsewhere on the board
/GPIO/GPIO_1: U17.13 (PA1); also elsewhere on the board
/GPIO/GPIO_2: U17.42 (PA8); also elsewhere on the board
/GPIO/GPIO_3: U17.43 (PA9); also elsewhere on the board
/GPIO/GPIO_4: U17.44 (PA10); also elsewhere on the board
/GPIO/GPIO_5: U17.45 (PA11); also elsewhere on the board
/GPIO/GPIO_6: U17.46 (PA12); also elsewhere on the board
/GPIO/GPIO_7: U17.51 (PA15); also elsewhere on the board
/GPIO/GPIO_8: U17.59 (PB6); also elsewhere on the board
/GPIO/GPIO_9: U17.60 (PB7); also elsewhere on the board
/GPIO/GPIO_10: U17.62 (PB9); also elsewhere on the board
/GPIO/GPIO_11: U17.11 (PC3); also elsewhere on the board
/GPIO/GPIO_12: U17.54 (PC12); also elsewhere on the board
/GPIO/GPIO_13: U17.3 (PC14); also elsewhere on the board
/GPIO/GPIO_14: U17.4 (PC15); also elsewhere on the board
/GPIO/GPIO_15: U17.55 (PD2); also elsewhere on the board
/MCU/BOOT: R19.1, U17.61 (PB8)
/MCU/DBG_BTN: C39.1, R22.2, SW1.1, U17.2 (PC13)
/MCU/DBG_LED0: R26.1, U17.56 (PB3)
/MCU/DBG_LED1: R25.1, U17.57 (PB4)
/MCU/DBG_LED2: R24.1, U17.58 (PB5)
/MCU/NRST: C40.1, R23.2, SW2.1, U17.7 (PG10); also elsewhere on the board
/MCU/PC6/I2C4_SCL: R39.2, U7.6 (SCL), U17.38 (PC6); also elsewhere on the board
/MCU/PC7/I2C4_SDA: R38.2, U7.5 (SDA), U17.39 (PC7); also elsewhere on the board
/Photodiodes/PHO_0: U17.37 (PB15); also elsewhere on the board
/Photodiodes/PHO_1: U17.36 (PB14); also elsewhere on the board
/Photodiodes/PHO_2: U17.34 (PB12); also elsewhere on the board
/Photodiodes/PHO_3: U17.25 (PB1); also elsewhere on the board
/Photodiodes/PHO_4: U17.24 (PB0); also elsewhere on the board
/Photodiodes/PHO_5: U17.10 (PC2); also elsewhere on the board
/Photodiodes/PHO_6: U17.9 (PC1); also elsewhere on the board
/Photodiodes/PHO_7: U17.8 (PC0); also elsewhere on the board
/Photodiodes/V_{REF}: U17.35 (PB13); also elsewhere on the board
GND: C28.2, C29.2, C30.2, C31.2, C32.2, C33.2, C34.2, C35.2, C36.2, C37.2, C38.2, C39.2, C40.2, C51.2, C52.2, D8.1 (K), D9.1 (K), D10.1 (K), R19.2, SW1.2, SW2.2, U7.1 (A0), U7.2 (A1), U7.3 (A2), U7.4 (VSS), U7.7 (WP), U17.15 (VSS), U17.27 (VSSA), U17.31 (VSS), U17.47 (VSS), U17.63 (VSS); also elsewhere on the board
unnamed: D8.2 (A), R24.2
unnamed: D9.2 (A), R25.2
unnamed: D10.2 (A), R26.2
unnamed: C36.1, U17.5 (PF0), Y1.2
unnamed: C37.1, U17.6 (PF1), Y1.1

Notes on the sheet:
SWCLK-JTCK/I2C1_SDA
ST-LINK
UART4_RX/SPI3_MISO/USART3_RX\I2C3_SDA
SPI2_MOSI
ADC12_IN1
External
RS485
ADC2_IN11/USART1_RX
SPI1_MOSI/SPI3_MOSI/I2C3_SDA
ADC4_IN3/ADC1_IN11
JTDI/I2C1_SCL/SPI1_NSS/SPI3_NSS/USART2_RX
ADC5_IN1/I2C3_SCL/I2C2_SDA
USART1_TX
BOOT/I2C1_SCL/USART3_RX
ADC1_IN3/USART2_TX
ADC5_IN2/USART1_TX
I2C3_SCL
UART5_TX/SPI3_MOSI
External [Li-Dar]
ADC3_IN12/ADC1_IN15
ADDR: 0b1010000 0x50
ADC12_IN9
ADC2_IN12
ADC12_IN8
ADC1_IN4/USART2_RX
FRAM + INA
I2C4_SDA
USART3_TX
ADC2_IN5/USART1_TX/I2C2_SCL
ADC2_IN4/SPI1_MOSI
ADC12_IN2
I2C3_SDA
ADC12_IN14/USART3_RX
ADC12_IN6
UART5_RX
I2C4_SCL
I2C4_SDA/I2C1_SDA/USART1_RX
ADC2_IN3/SPI1_MISO
ADC2_IN17/SPI1_NSS
SWDIO-JTMS/I2C4_SCL/I2C1_SCL
JTRST/SPI1_MISO/SPI3_MISO/USART2_RX
FRAM
ADC3_IN1/ADC1_IN12
ADC2_IN13/SPI1_SCK
ESP32?
ADC3_IN5/PI2_SCK/I2S2_CK
ADC4_IN4/ADC1_IN5/SPI2_MISO
JTDO-TRACESWO/SPI1_SCK/SPI3_SCK/USART2_TX
UART4_TX/SPI3_SCK/I2S3_CK/USART3_TX
ADC4_IN5/ADC2_IN15/SPI2_MOSI
External [IMU]
I2C1_SDA/USART3_TX
ADC12_IN7
SPI2_MISO/USART1_RX
Dodać więcej kondensatorów, spróbować przenieść piny na lepszą STMkę
New cortex (STM32G474RET6) : https://www.google.com/url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

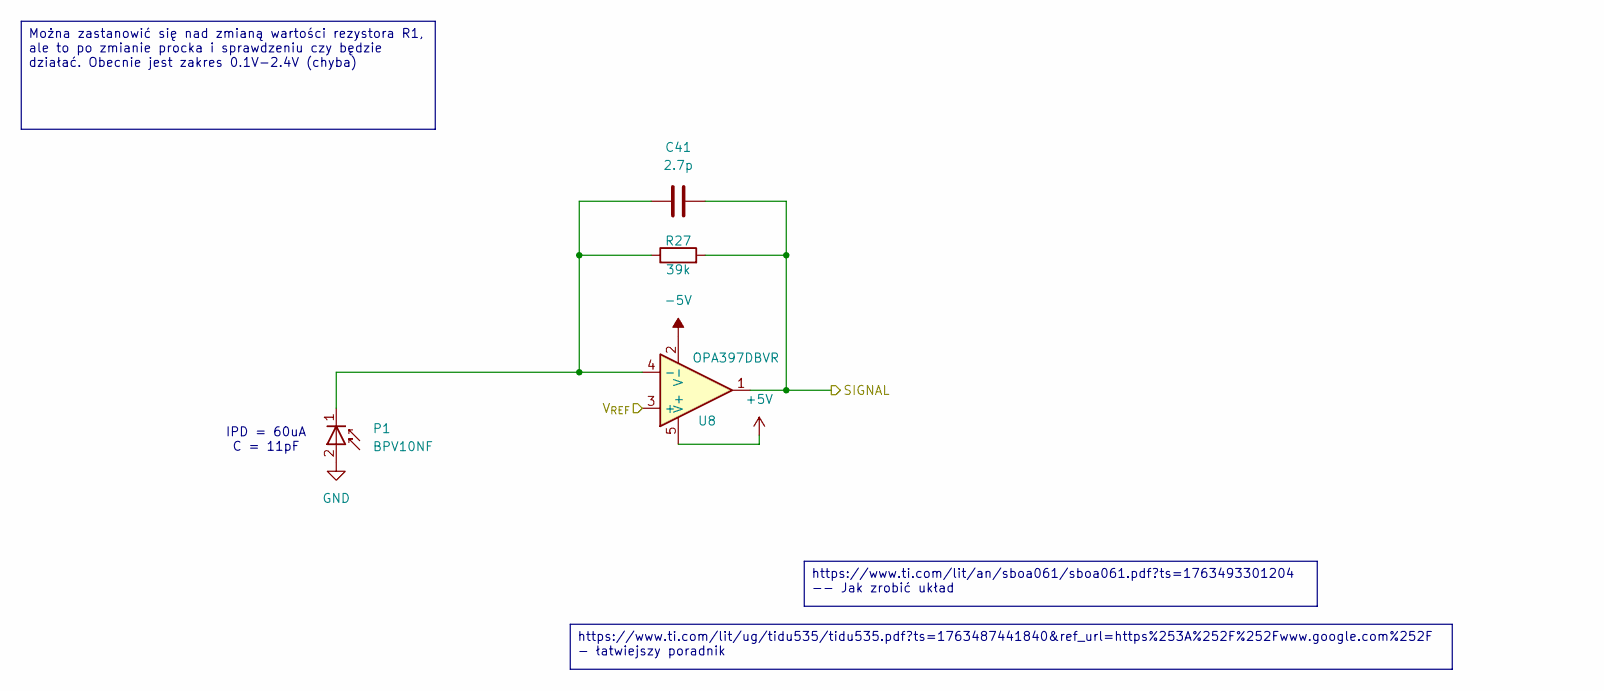
[picture p21: schematic photodiode.kicad_sch, uMule_board]

Parts:
C41: 2.7p; C_0402_1005Metric
P1: BPV10NF; D_T-1_P2.54mm_Vertical_KathodeUp
R27: 39k; R_0603_1608Metric
U8: OPA397DBVR; SOT-23-5

Connections:
+5V: U8.5 (V+); also elsewhere on the board
-5V: U8.2 (V-); also elsewhere on the board
/Photodiodes/PHO_0: C41.2, R27.2, U8.1; also elsewhere on the board
/Photodiodes/V_{REF}: U8.3 (+); also elsewhere on the board
GND: P1.2 (A); also elsewhere on the board
unnamed: C41.1, P1.1 (K), R27.1, U8.4 (-)

Parts of its further copies:
C42, C43, C44, C45, C46, C47, C48: 2.7p; C_0402_1005Metric
P2, P3, P4, P5, P6, P7, P8: BPV10NF; D_T-1_P2.54mm_Vertical_KathodeUp
R28, R29, R30, R31, R32, R33, R34: 39k; R_0603_1608Metric
U9, U10, U11, U12, U13, U14, U15: OPA397DBVR; SOT-23-5

Connections of its further copies:
+5V: U9.5 (V+), U10.5 (V+), U11.5 (V+), U12.5 (V+), U13.5 (V+), U14.5 (V+), U15.5 (V+); also elsewhere on the board
-5V: U9.2 (V-), U10.2 (V-), U11.2 (V-), U12.2 (V-), U13.2 (V-), U14.2 (V-), U15.2 (V-); also elsewhere on the board
/Photodiodes/PHO_1: C42.2, R28.2, U9.1; also elsewhere on the board
/Photodiodes/PHO_2: C43.2, R29.2, U10.1; also elsewhere on the board
/Photodiodes/PHO_3: C44.2, R30.2, U11.1; also elsewhere on the board
/Photodiodes/PHO_4: C45.2, R31.2, U12.1; also elsewhere on the board
/Photodiodes/PHO_5: C46.2, R32.2, U13.1; also elsewhere on the board
/Photodiodes/PHO_6: C47.2, R33.2, U14.1; also elsewhere on the board
/Photodiodes/PHO_7: C48.2, R34.2, U15.1; also elsewhere on the board
/Photodiodes/V_{REF}: U9.3 (+), U10.3 (+), U11.3 (+), U12.3 (+), U13.3 (+), U14.3 (+), U15.3 (+); also elsewhere on the board
GND: P2.2 (A), P3.2 (A), P4.2 (A), P5.2 (A), P6.2 (A), P7.2 (A), P8.2 (A); also elsewhere on the board
unnamed: C42.1, P2.1 (K), R28.1, U9.4 (-)
unnamed: C43.1, P3.1 (K), R29.1, U10.4 (-)
unnamed: C44.1, P4.1 (K), R30.1, U11.4 (-)
unnamed: C45.1, P5.1 (K), R31.1, U12.4 (-)
unnamed: C46.1, P6.1 (K), R32.1, U13.4 (-)
unnamed: C47.1, P7.1 (K), R33.1, U14.4 (-)
unnamed: C48.1, P8.1 (K), R34.1, U15.4 (-)

Notes on the sheet:
IPD = 60uA C = 11pF
https://www.ti.com/lit/ug/tidu535/tidu535.pdf?ts=1763487441840&ref_url=https%253A%252F%252Fwww.google.com%252F - łatwiejszy poradnik
https://www.ti.com/lit/an/sboa061/sboa061.pdf?ts=1763493301204 -- Jak zrobić układ
Można zastanowić się nad zmianą wartości rezystora R1, ale to po zmianie procka i sprawdzeniu czy będzie działać. Obecnie jest zakres 0.1V-2.4V (chyba)

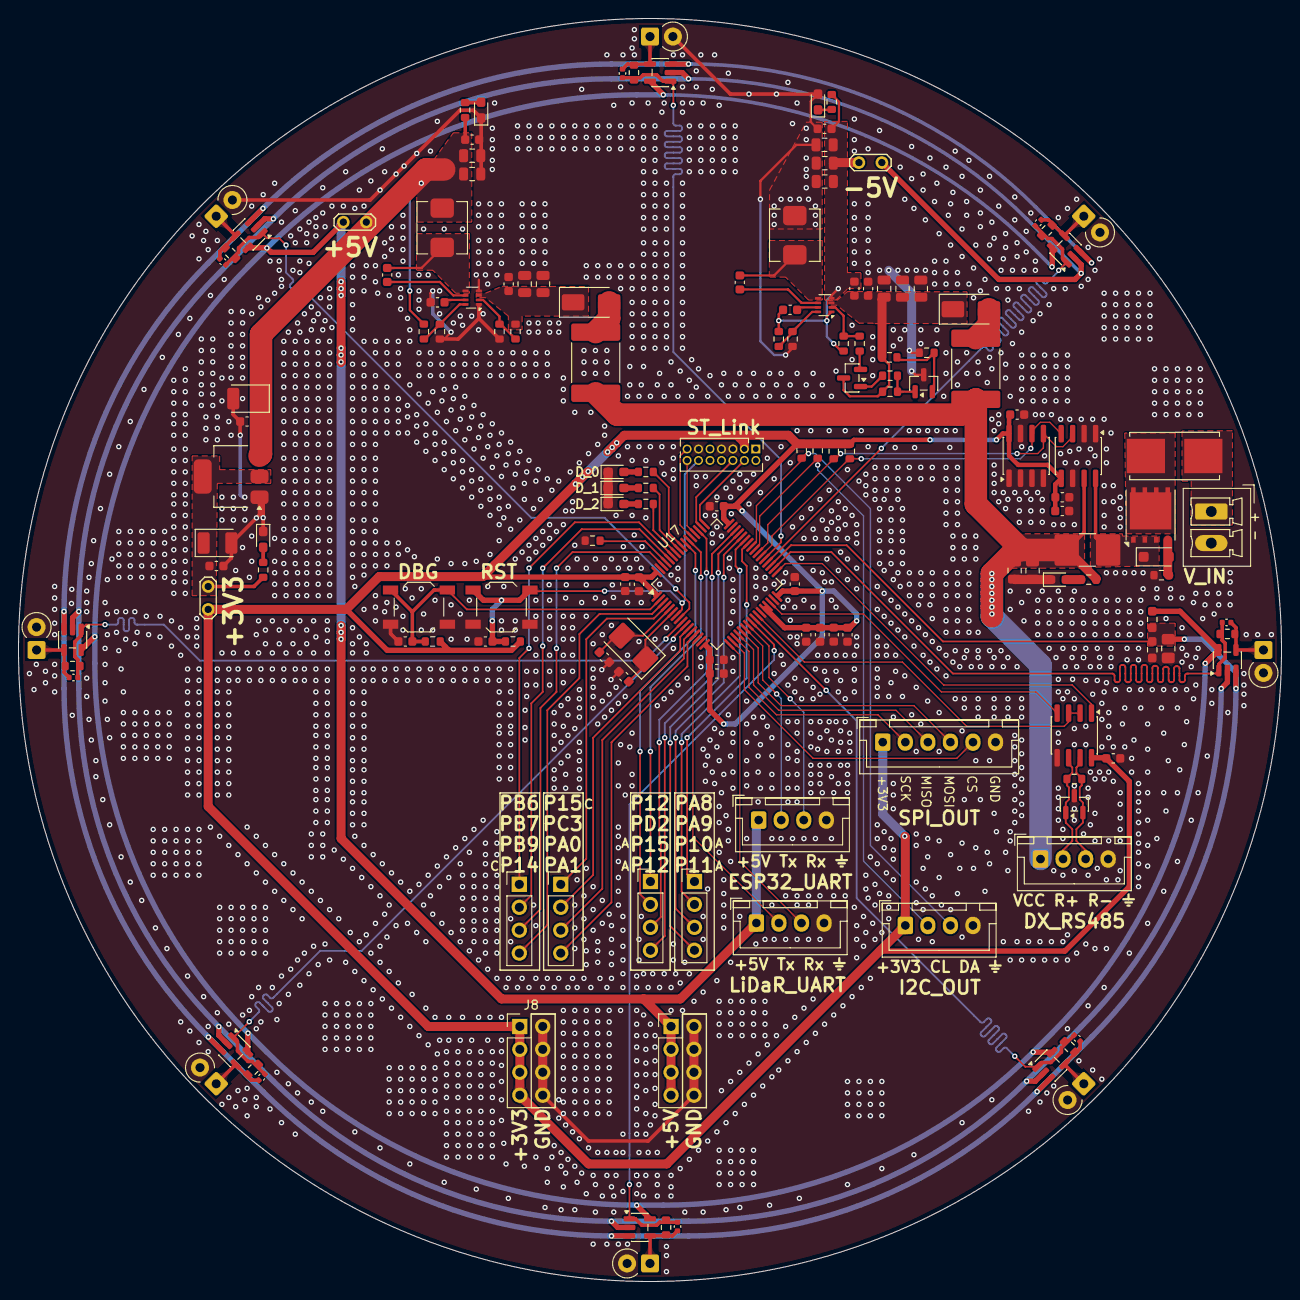
[picture p22: board uMule_board.kicad_pcb from above]

Board: 2 copper layers, 140.0 x 140.0 mm, 152 parts (0 on the bottom side), 99 nets.
