OliWozniak/Projekt_EAP_OW/(commit log)

2025-12-03 added notes for development
    [photodiode.kicad_sch, uMule_board.kicad_sch]
2025-12-03 addd buses and simple connections
    [mcu.kicad_sch, photodiode.kicad_sch, uMule_board.kicad_sch]
2025-12-04 Some calculations were made. Photodiode, amplifier and main procesor are chosen
    [mcu.kicad_sch, photodiode.kicad_sch, uMule_board.kicad_sch]
2025-12-06 all main componenst added. Prepared to change MCU. SCH almost ready
    [communication.kicad_sch, mcu.kicad_sch, photodiode.kicad_sch, photodiodes_all.kicad_sch, power.kicad_sch, rs485.kicad_sch, uMule_board.kicad_sch]
2025-12-13 Finished schematics. Now ready for PCB
    [communication.kicad_sch, gpio.kicad_sch, mcu.kicad_sch, output.kicad_sch, outputs.kicad_sch, photodiode.kicad_sch, power.kicad_sch, rs485.kicad_sch]
2025-12-14 Started working on PCB. Ditched high power outputs. Focusing on photodiodes. One commit closer to order
    [communication.kicad_sch, gpio.kicad_sch, mcu.kicad_sch, output.kicad_sch, outputs.kicad_sch, photodiode.kicad_sch, photodiodes_all.kicad_sch, power.kicad_sch]
2025-12-14 modified pdf files
    [uMule_board.kicad_pcb]
2025-12-20 removed half phototransistors, etc.
    [div_calc.ods, gpio.kicad_sch, mcu.kicad_sch, photodiode.kicad_sch, photodiodes_all.kicad_sch, power.kicad_sch, uMule_board.kicad_sch]
2025-12-21 sch ready, only missing the pcb
    [communication.kicad_sch, gpio.kicad_sch, mcu.kicad_sch, photodiode.kicad_sch, photodiodes_all.kicad_sch, power.kicad_sch, uMule_board.kicad_pcb, uMule_board.kicad_sch]
2025-12-23 board before I place photodides
    [uMule_board.kicad_pcb]
2025-12-24 after placing photodiodes
    [uMule_board.kicad_pcb]
2025-12-25 placed uC, initial traces connection, Matrzed trases lenghts for photodiodes (idk why)
    [uMule_board.kicad_pcb, uMule_board.kicad_sch]
2025-12-25 another day, more progress. Elements are placed on board, traces need to be conected, added jumpers for power in case of bad design
    [mcu.kicad_sch, uMule_board.kicad_pcb, uMule_board.kicad_sch]
2025-12-28 DRC Passed, now only slight modifications on traces left, lenght matching and proper board description
    [gpio.kicad_sch, power.kicad_sch, uMule_board.kicad_pcb, uMule_board.kicad_sch]
2025-12-28 Added descriptions and teardrops. Ready for JLCPCB
    [uMule_board.kicad_pcb]
2025-12-29 initial commit for new processor. Need to adjust pinout and layout of board. Try not to change elements names to save DC converters and photodiodes layout
    [mcu.kicad_sch]
2025-12-31 Described pinout. Board seems viable
    [mcu.kicad_sch]
2025-12-31 initial board is ready for conecting
    [gpio.kicad_sch, mcu.kicad_sch, uMule_board.kicad_pcb, uMule_board.kicad_sch]
2025-12-31 Added drawings
    [uMule_board.kicad_pcb]
2026-01-02 All elements connected. Now making more vias and corrections
    [gpio.kicad_sch, mcu.kicad_sch, uMule_board.kicad_pcb, uMule_board.kicad_sch]
2026-01-04 Board finished, ready to order
    [uMule_board-CuBottom.gbr, uMule_board-CuTop.gbr, uMule_board-EdgeCuts.gbr, uMule_board-MaskBottom.gbr, uMule_board-MaskTop.gbr, uMule_board-NPTH.drl, uMule_board-PTH.drl, uMule_board-SilkBottom.gbr]
2026-01-05 Commit for transmitter board. Oscillator is calculated and circuit is made. I should make simulations before completing board but circuit is foolproof. Quadrature oscillator will be used as it provid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
    [oscilator_calc.ods, uMule_transmiter.kicad_pcb, uMule_transmiter.kicad_sch]
2026-01-06 Transmiter board finnished. Ready for JLCPCB
    [led_controller.kicad_sch, oscilator.kicad_sch, uMule_transmiter.kicad_pcb, uMule_transmiter.kicad_sch]
2026-01-06 JLC Ready, now waiting for shipment
    [led_controller.kicad_sch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]
2026-01-27 current board. Everything is finnished
    [uMule_board-CuBottom.gbr, uMule_board-CuTop.gbr, uMule_board-EdgeCuts.gbr, uMule_board-MaskBottom.gbr, uMule_board-MaskTop.gbr, uMule_board-NPTH.drl, uMule_board-PTH.drl, uMule_board-SilkBottom.gbr]
2026-05-02 added 3d model
    [uMule_board.step]
